Benergy80/PartitionSystem/ELEVATOR ENTRY SHOP AND STP FILES/Elevator Entry Inventory.jpg

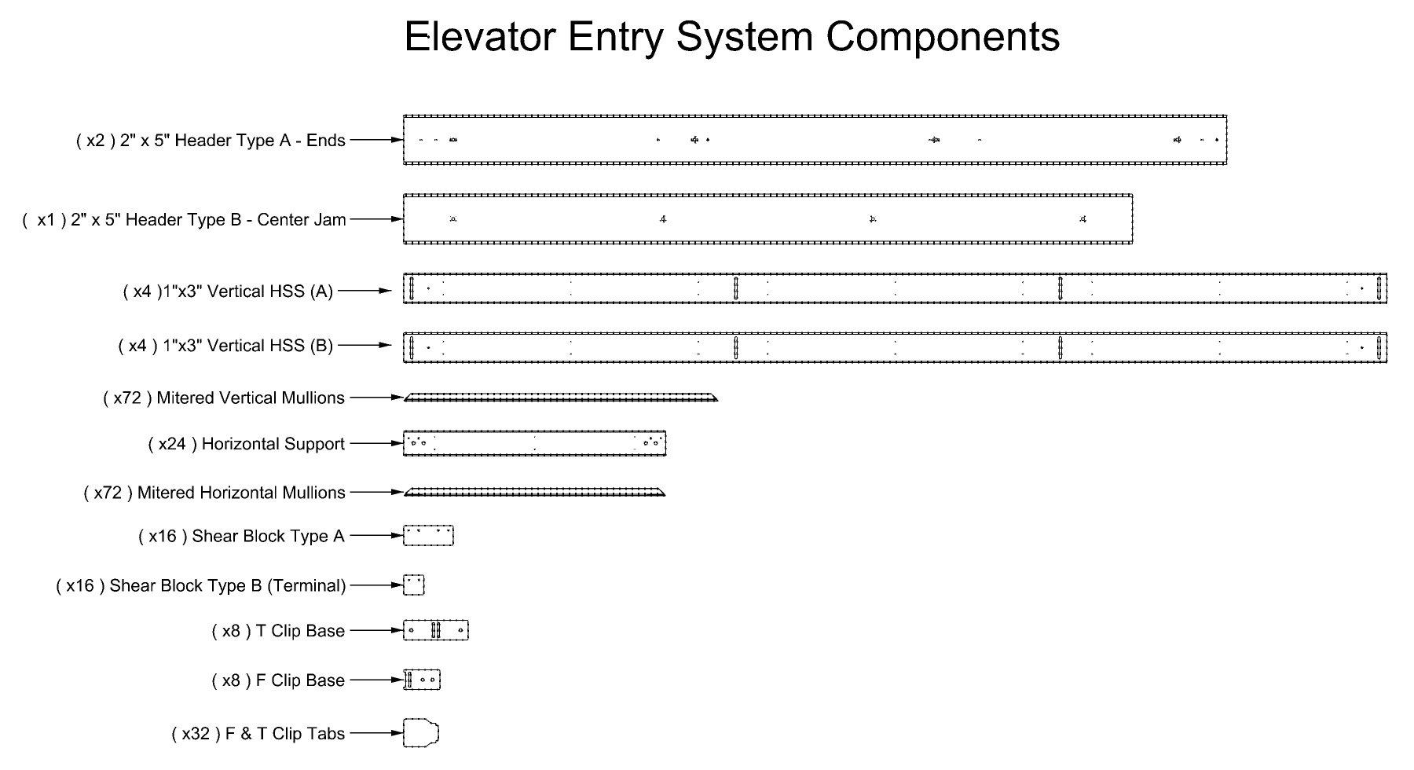
ELEVATOR ENTRY SHOP AND STP FILES/Elevator Entry Inventory.jpg
