Benergy80/PartitionSystem/ELEVATOR ENTRY SHOP AND STP FILES/EL Horizontal Support x24.stp

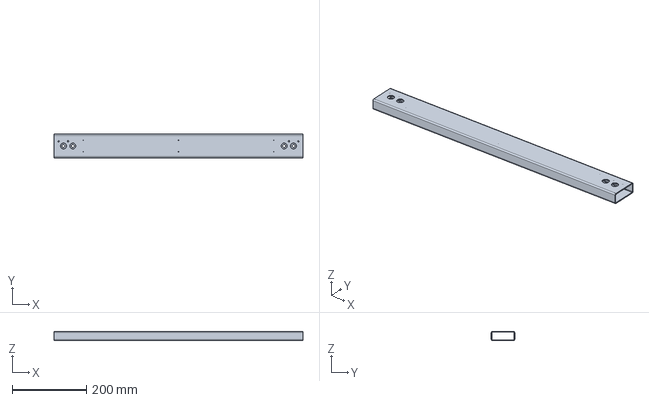
[picture p2: CAD file, 2026-07-02]
ELEVATOR ENTRY SHOP AND STP FILES/EL Horizontal Support x24.stp
671.8 x 63.5 x 25.4 mm
