Benergy80/PartitionSystem/ELEVATOR ENTRY SHOP AND STP FILES/Shear Block Type A x16.stp

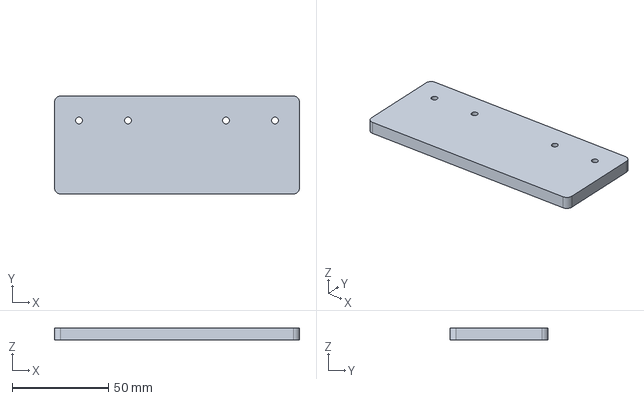
[picture p3: CAD file, 2026-07-02]
ELEVATOR ENTRY SHOP AND STP FILES/Shear Block Type A x16.stp
127.0 x 50.8 x 6.35 mm
