Benergy80/PartitionSystem/ELEVATOR ENTRY SHOP AND STP FILES/EL Vertical Support Type A x4.stp

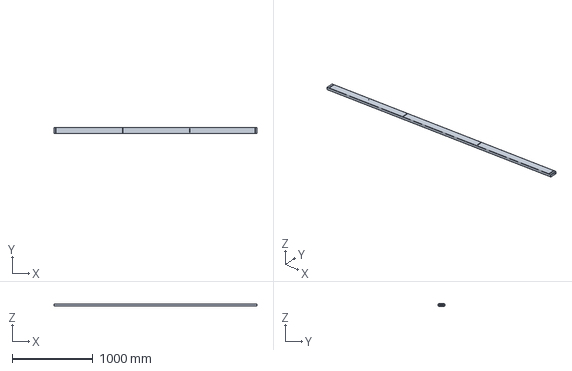
[picture p4: CAD file, 2026-07-02]
ELEVATOR ENTRY SHOP AND STP FILES/EL Vertical Support Type A x4.stp
2520.9 x 76.2 x 25.4 mm
