Benergy80/PartitionSystem/ELEVATOR ENTRY SHOP AND STP FILES/F & T Clip Tabs x32.stp

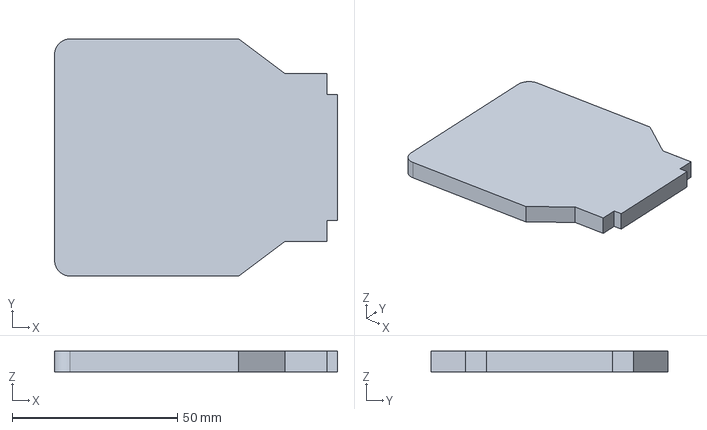
[picture p5: CAD file, 2026-07-02]
ELEVATOR ENTRY SHOP AND STP FILES/F & T Clip Tabs x32.stp
85.7 x 71.9 x 6.35 mm
