Benergy80/PartitionSystem/ELEVATOR ENTRY SHOP AND STP FILES/EL Mitered Vertical Mullions x72.stp

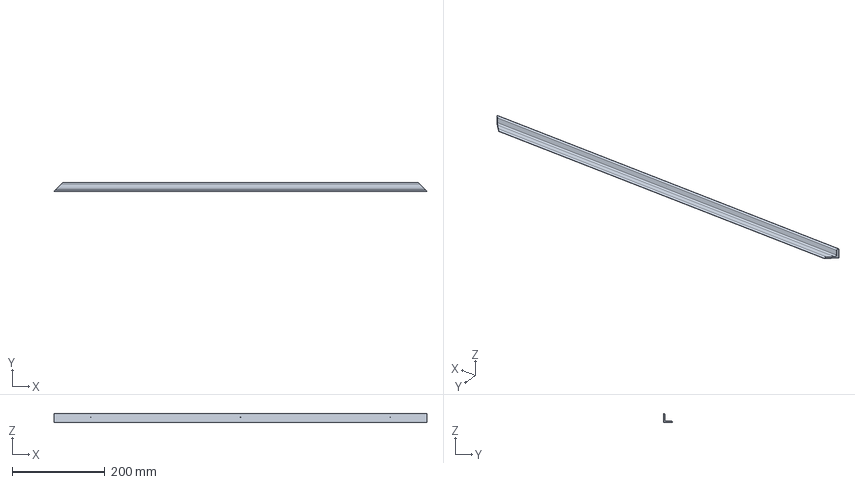
[picture p6: CAD file, 2026-07-02]
ELEVATOR ENTRY SHOP AND STP FILES/EL Mitered Vertical Mullions x72.stp
806.4 x 19.1 x 19.1 mm
