Benergy80/PartitionSystem/ELEVATOR ENTRY SHOP AND STP FILES/EL Header Type B x1.stp

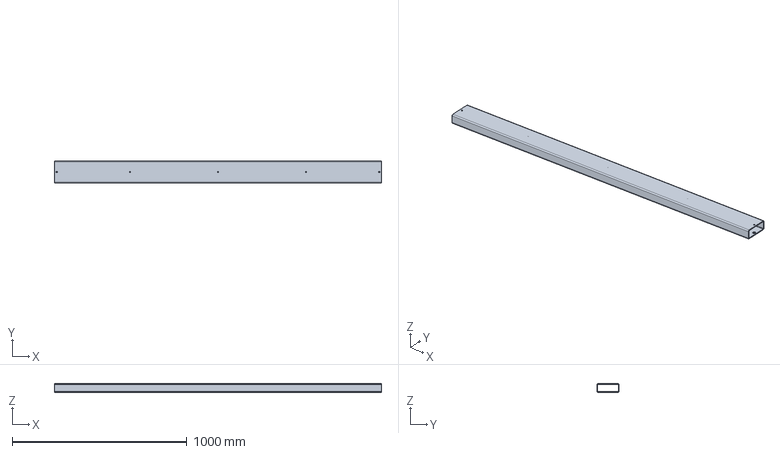
[picture p7: CAD file, 2026-07-02]
ELEVATOR ENTRY SHOP AND STP FILES/EL Header Type B x1.stp
1868.6 x 127.0 x 50.8 mm
