Benergy80/PartitionSystem/ELEVATOR ENTRY SHOP AND STP FILES/Shear Block Type B x16.stp

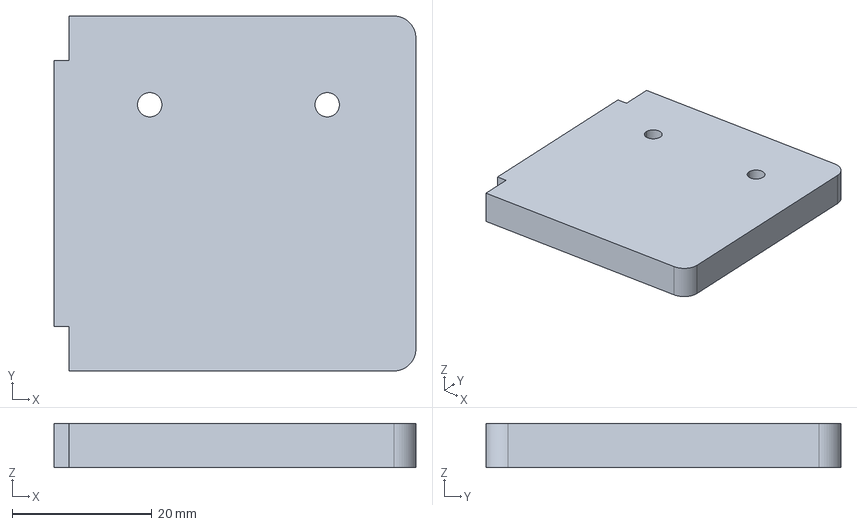
[picture p9: CAD file, 2026-07-02]
ELEVATOR ENTRY SHOP AND STP FILES/Shear Block Type B x16.stp
51.8 x 50.8 x 6.35 mm
