Benergy80/PartitionSystem/ELEVATOR ENTRY SHOP AND STP FILES/EL Header Type A x2.stp

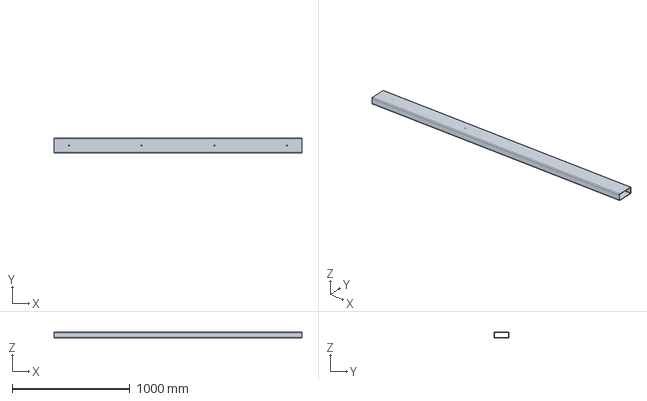
[picture p10: CAD file, 2026-07-02]
ELEVATOR ENTRY SHOP AND STP FILES/EL Header Type A x2.stp
2110.5 x 127.0 x 50.8 mm
