Benergy80/PartitionSystem/ELEVATOR ENTRY SHOP AND STP FILES/F Clip Base x8.stp

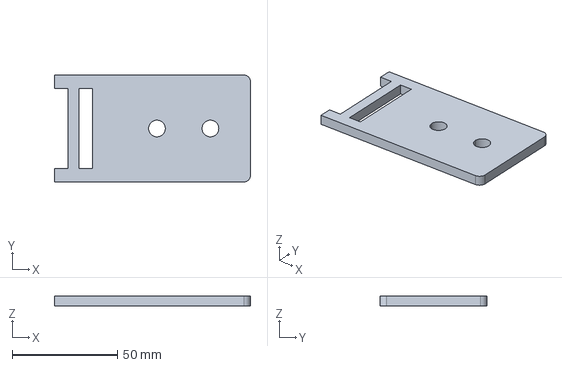
[picture p11: CAD file, 2026-07-02]
ELEVATOR ENTRY SHOP AND STP FILES/F Clip Base x8.stp
93.1 x 50.8 x 4.76 mm
