Benergy80/PartitionSystem/ELEVATOR ENTRY SHOP AND STP FILES/EL Mitered Horizontal Mullions x72.stp

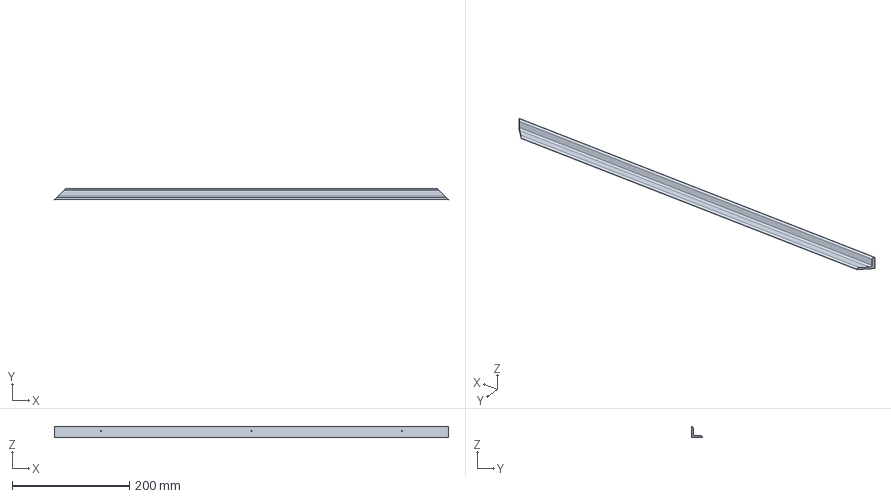
[picture p12: CAD file, 2026-07-02]
ELEVATOR ENTRY SHOP AND STP FILES/EL Mitered Horizontal Mullions x72.stp
671.8 x 19.1 x 19.1 mm
