Benergy80/PartitionSystem/(list of files, cad)

Other CAD files:
ELEVATOR ENTRY SHOP AND STP FILES/EL Vertical Support Type B x4.stp
