Benergy80/PartitionSystem/102219.004.01 - ChiLabs 6th Floor Elevator Entrance and Board 020524 (1).pdf

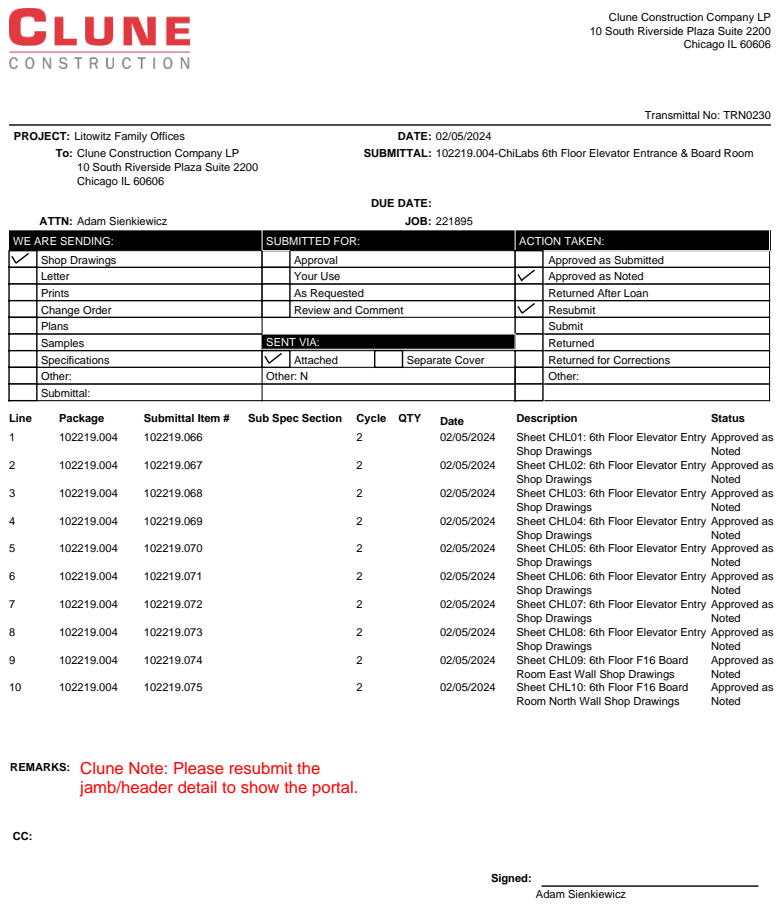
[picture p13: page 1]
Transmittal No: TRN0230; Chicago IL 60606; PROJECT: Litowitz Family Offices; DATE: 02/05/2024; DUE DATE:; ATTN: Adam Sienkiewicz; JOB: 221895; WE ARE SENDING: Shop Drawings; Change Order; SENT VIA:; Other: N; Attached; Separate Cover; Line; Package; Submittal Item #; Sub Spec Section Cycle QTY; Date; Description; Status; Sheet CHL01: 6th Floor Elevator Entry; Shop Drawings; Approved as; Sheet CHL02: 6th Floor Elevator Entry; Sheet CHL03: 6th Floor Elevator Entry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

Clune Construction Company LP
10 South Riverside Plaza Suite 2200

Chicago IL 60606

SUBMITTAL: 102219.004-ChiLabs 6th Floor Elevator Entrance & Board Room

SUBMITTED FOR:
Approval
Your Use
As Requested
Review and Comment

ACTION TAKEN:
Approved as Submitted
Approved as Noted
Returned After Loan
Resubmit
Submit
Returned
Returned for Corrections
Other:

Room East Wall Shop Drawings

Room North Wall Shop Drawings

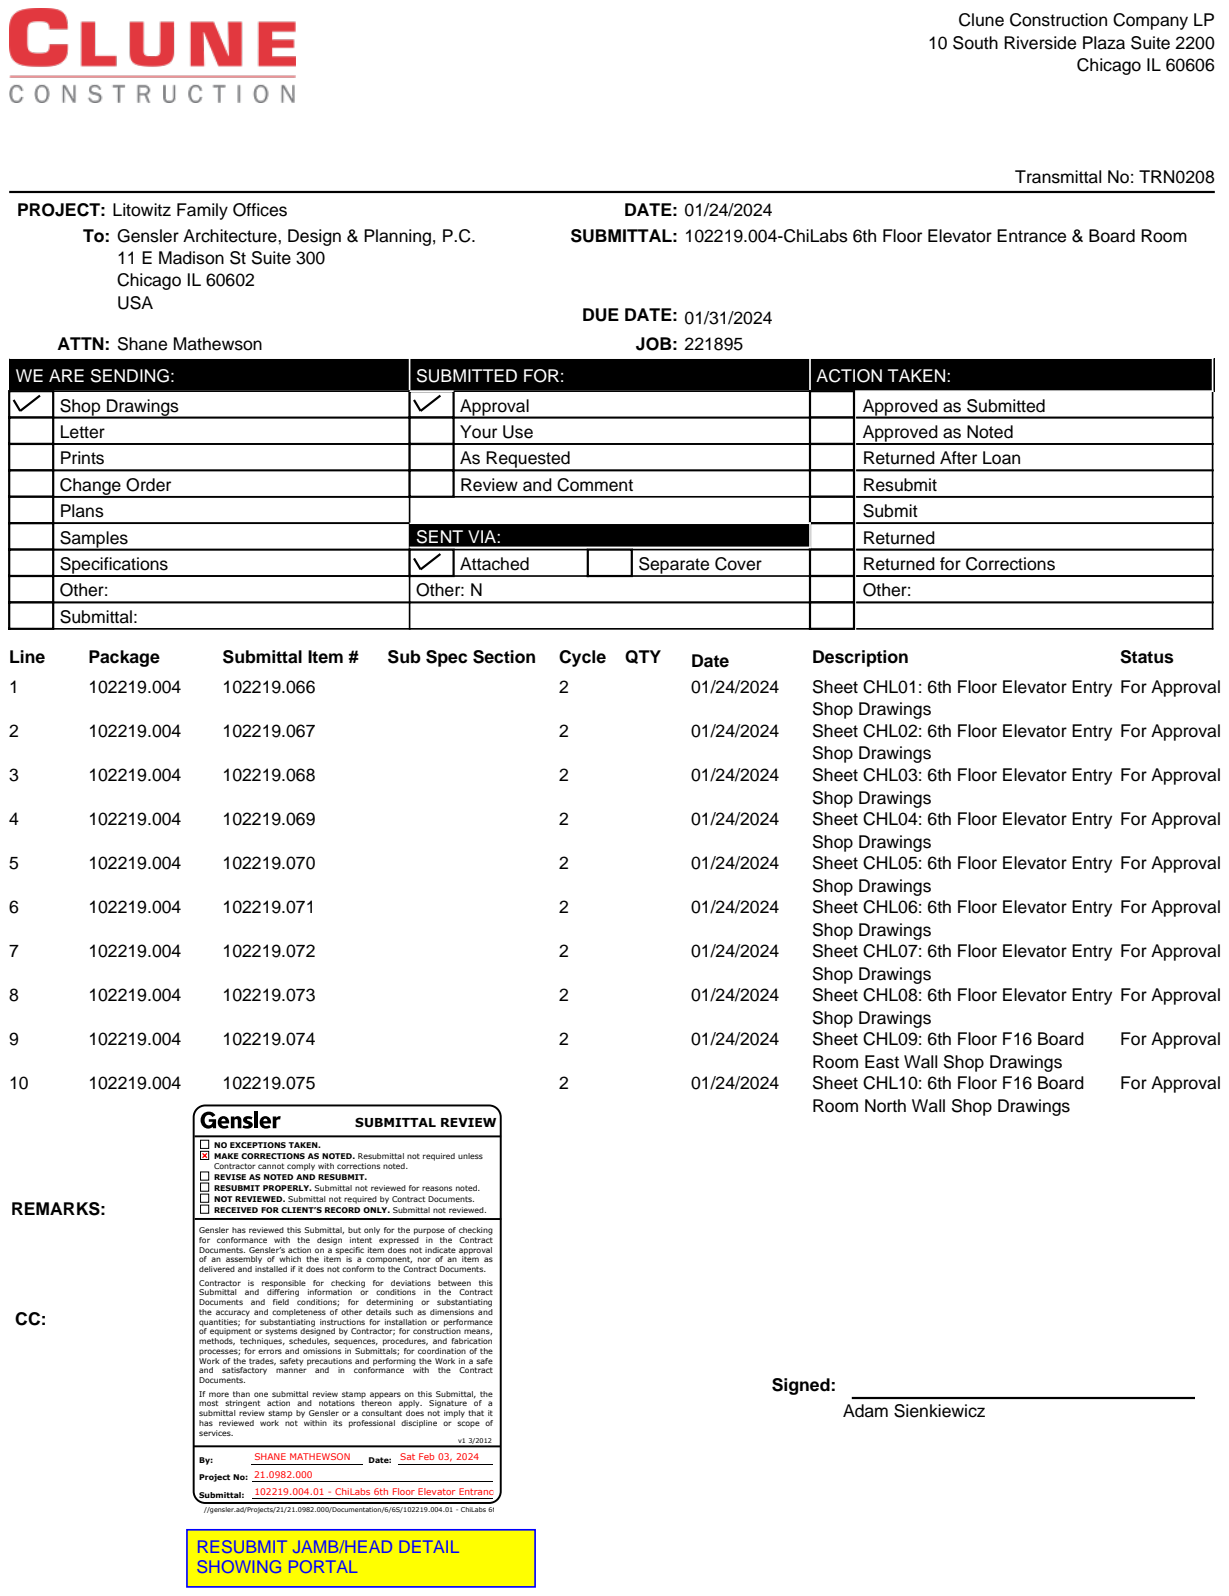
[picture p14: page 2]
Transmittal No: TRN0208; Chicago IL 60606; PROJECT: Litowitz Family Offices; DATE: 01/24/2024; DUE DATE:; ATTN: Shane Mathewson; JOB: 221895; WE ARE SENDING: Shop Drawings; Change Order; SENT VIA:; Other: N; Attached; Separate Cover; Line; Package; Submittal Item #; Sub Spec Section Cycle QTY; Date; Description; Status; Sheet CHL01: 6th Floor Elevator Entry; Shop Drawings; For Approval; Sheet CHL02: 6th Floor Elevator Entry; Sheet CHL03: 6th Floor Elevator Entry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

Clune Construction Company LP
10 South Riverside Plaza Suite 2200

Gensler Architecture, Design & Planning, P.C.
11 E Madison St Suite 300
Chicago IL 60602
USA

102219.004-ChiLabs 6th Floor Elevator Entrance & Board Room

SUBMITTED FOR:
Approval
Your Use
As Requested
Review and Comment

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

Room East Wall Shop Drawings

Room North Wall Shop Drawings

NO EXCEPTIONS TAKEN.
MAKE CORRECTIONS AS NOTED. Resubmittal not required unless
Contractor cannot comply with corrections noted.
REVISE AS NOTED AND RESUBMIT.
RESUBMIT PROPERLY. Submittal not reviewed for reasons noted.
NOT REVIEWED. Submittal not required by Contract Documents.
RECEIVED FOR CLIENT’S RECORD ONLY. Submittal not reviewed.
Gensler has reviewed this Submittal, but only for the purpose of checking
for conformance with the design intent expressed in the Contract
Documents. Gensler’s action on a specific item does not indicate approval
of an assembly of which the item is a component, nor of an item as
delivered and installed if it does not conform to the Contract Documents.
Contractor is responsible for checking for deviations between this
Submittal and differing information or conditions in the Contract
Documents and field conditions; for determining or substantiating
the accuracy and completeness of other details such as dimensions and
quantities; for substantiating instructions for installation or performance
of equipment or systems designed by Contractor; for construction means,
methods, techniques, schedules, sequences, procedures, and fabrication
processes; for errors and omissions in Submittals; for coordination of the
Work of the trades, safety precautions and performing the Work in a safe
and satisfactory manner and in conformance with the Contract
Documents.
If more than one submittal review stamp appears on this Submittal, the
most stringent action and notations thereon apply. Signature of a
submittal review stamp by Gensler or a consultant does not imply that it
has reviewed work not within its professional discipline or scope of

RESUBMIT JAMB/HEAD DETAIL
SHOWING PORTAL

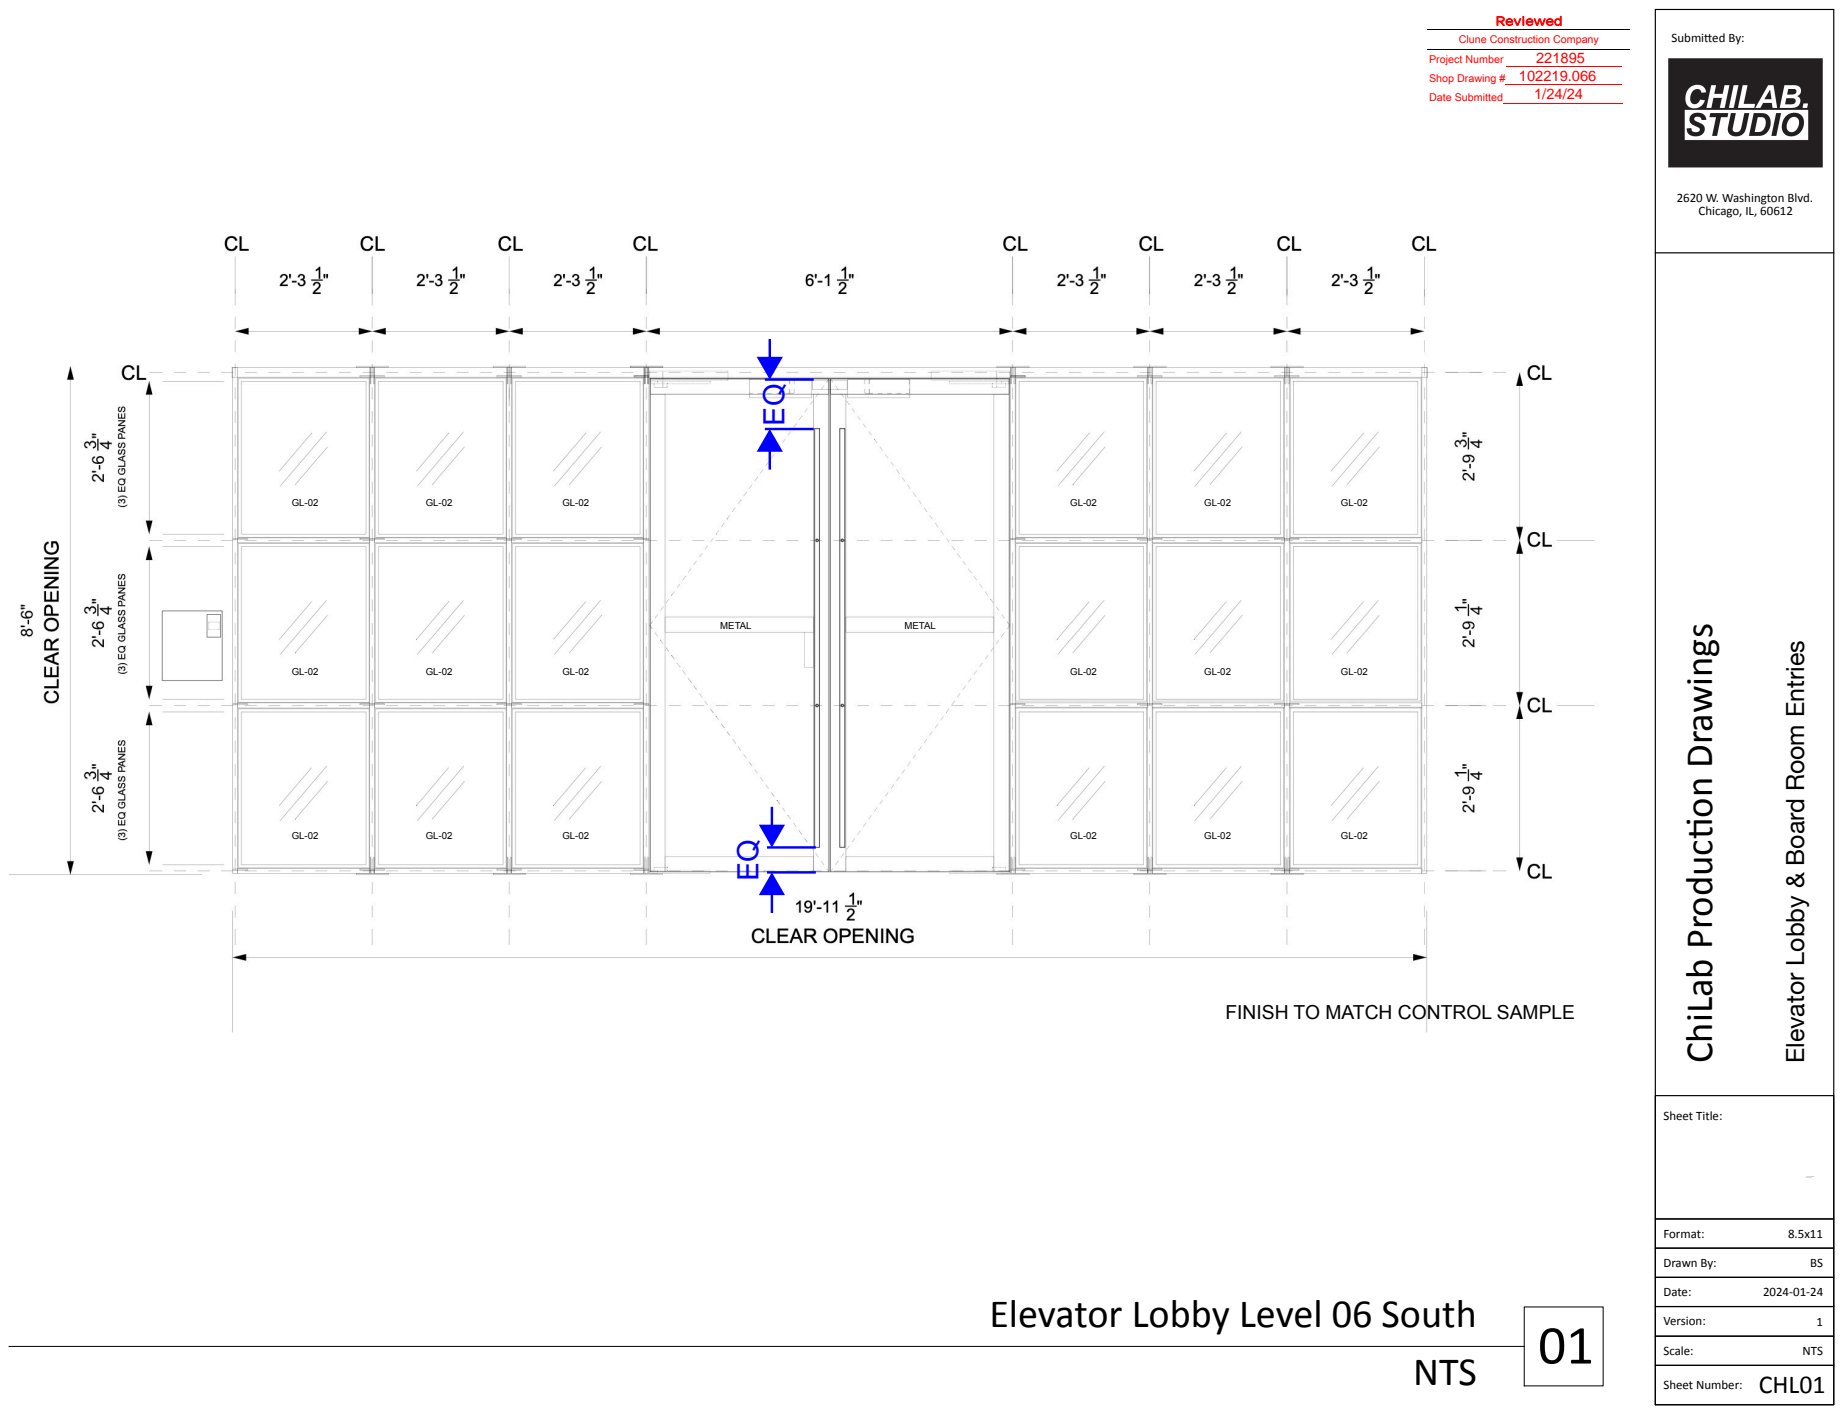
[picture p15: page 3]
Elevator Lobby Level 06 South; Sheet Number:; Drawn By:; Sheet Title:; 2620 W. Washington Blvd. Chicago, IL, 60612; Project Number Shop Drawing #; Date Submitted

Reviewed
Clune Construction Company
SubmiFed By: ChiLab Produc5on Drawings

Elevator Lobby & Board Room Entries

FINISH TO MATCH CONTROL SAMPLE

Elevator Lobby Eleva5on
Sheet Title Line 2

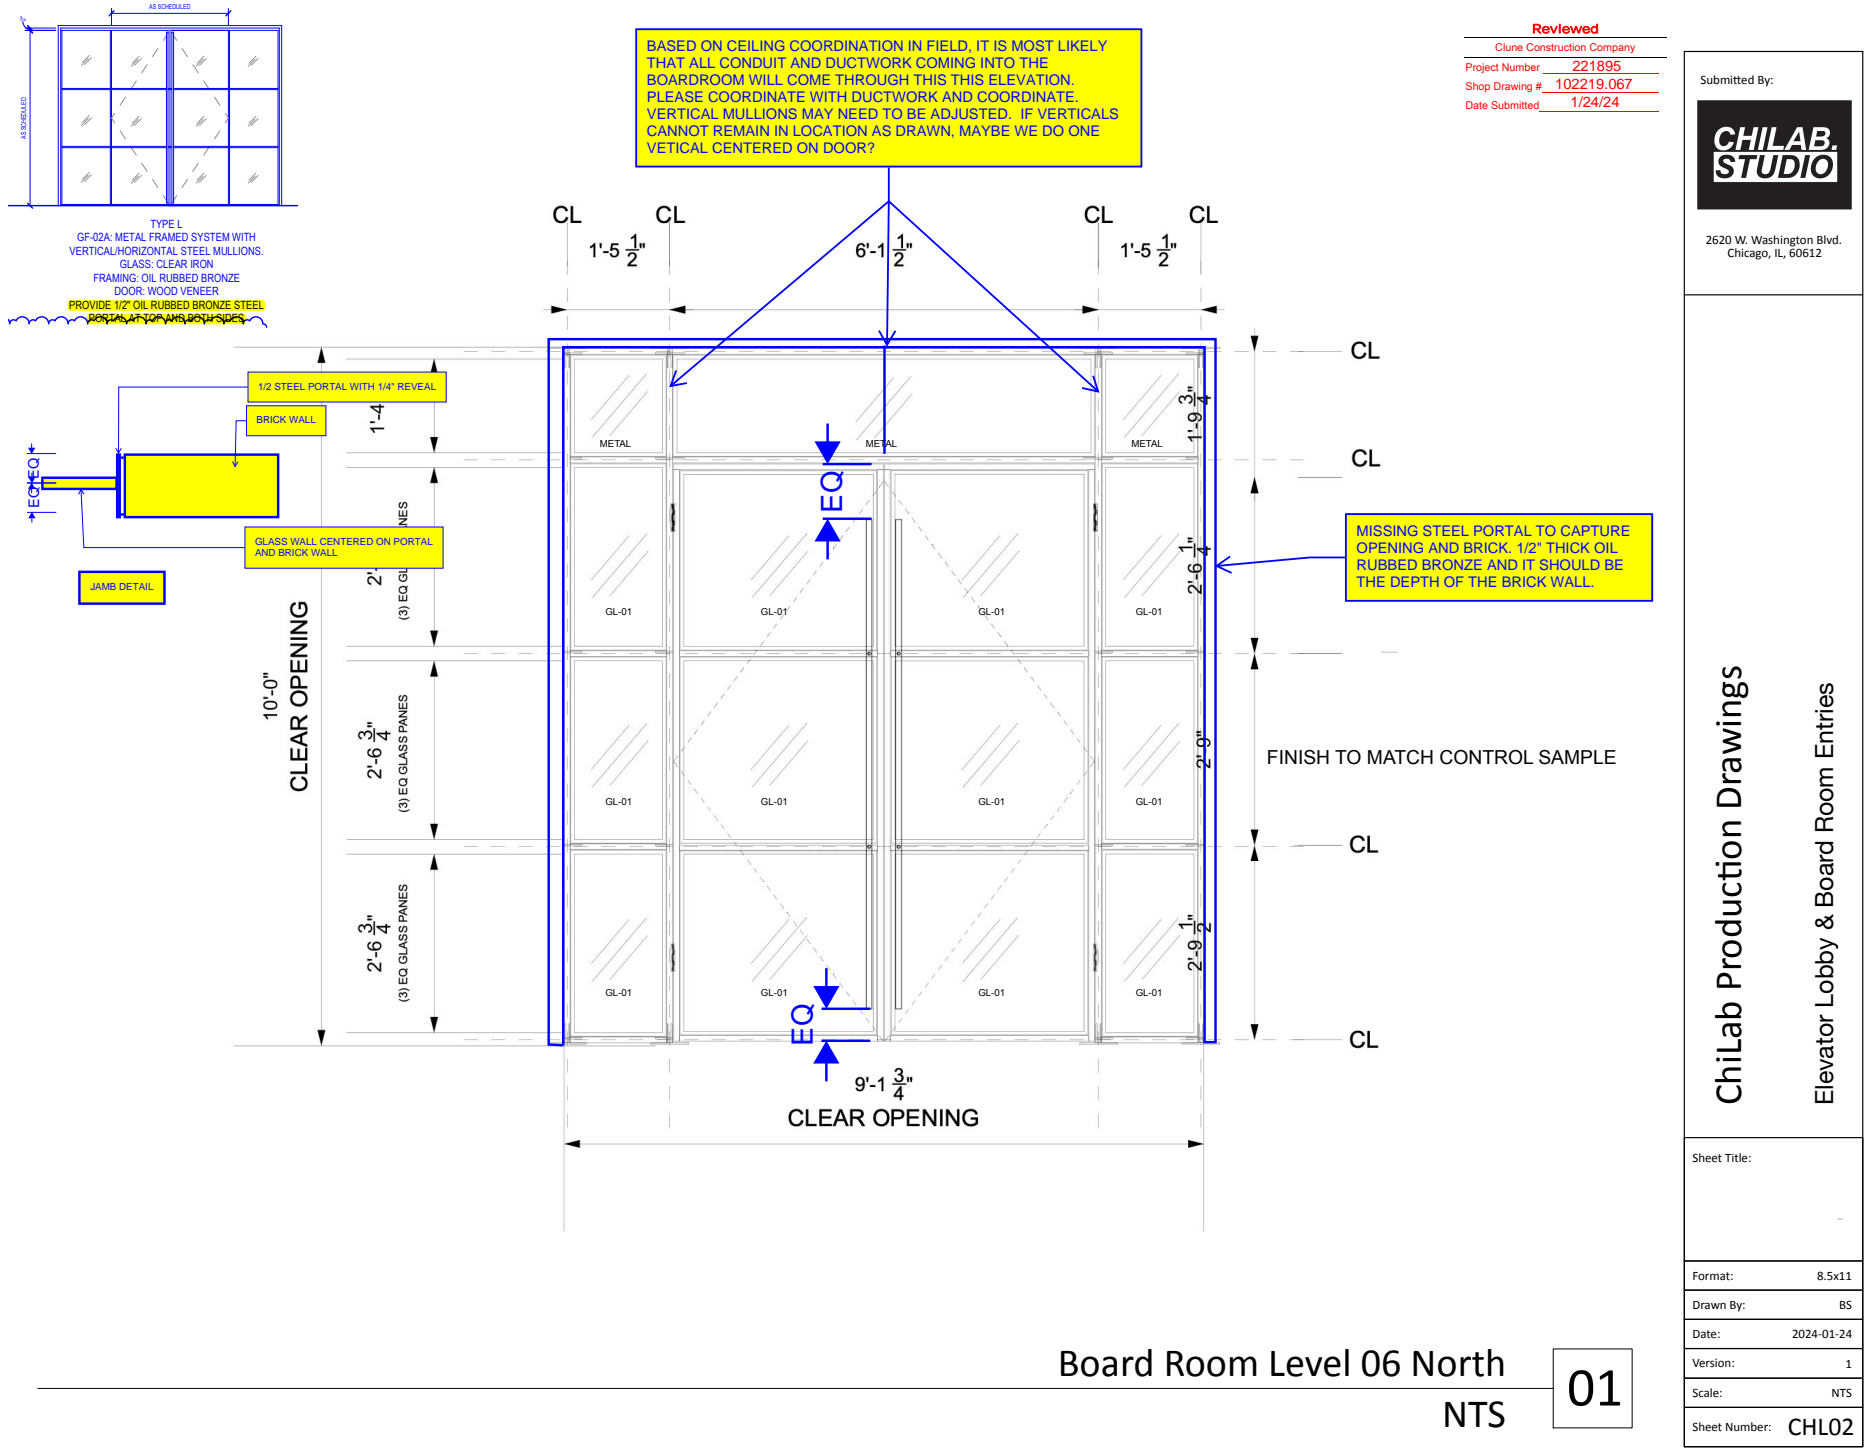
[picture p16: page 4]
Board Room Level 06 North; Drawn By:; Sheet Title:; 2620 W. Washington Blvd. Chicago, IL, 60612; Date Submitted; TYPE L; AS SCHEDULED; AS SCHEDULED 2"; BRICK WALL; JAMB DETAIL

BASED ON CEILING COORDINATION IN FIELD, IT IS MOST LIKELY
THAT ALL CONDUIT AND DUCTWORK COMING INTO THE
BOARDROOM WILL COME THROUGH THIS THIS ELEVATION.
PLEASE COORDINATE WITH DUCTWORK AND COORDINATE.
VERTICAL MULLIONS MAY NEED TO BE ADJUSTED. IF VERTICALS
CANNOT REMAIN IN LOCATION AS DRAWN, MAYBE WE DO ONE
VETICAL CENTERED ON DOOR?

SubmiFed By: ChiLab Produc5on Drawings

GF-02A: METAL FRAMED SYSTEM WITH
VERTICAL/HORIZONTAL STEEL MULLIONS.

GLASS: CLEAR IRON
FRAMING: OIL RUBBED BRONZE
DOOR: WOOD VENEER

PROVIDE 1/2" OIL RUBBED BRONZE STEEL
PORTAL AT TOP AND BOTH SIDES

1/2 STEEL PORTAL WITH 1/4" REVEAL

GLASS WALL CENTERED ON PORTAL
AND BRICK WALL

MISSING STEEL PORTAL TO CAPTURE
OPENING AND BRICK. 1/2" THICK OIL
RUBBED BRONZE AND IT SHOULD BE
THE DEPTH OF THE BRICK WALL.

Elevator Lobby & Board Room Entries

FINISH TO MATCH CONTROL SAMPLE

Sheet Title Line 1
Sheet Title Line 2

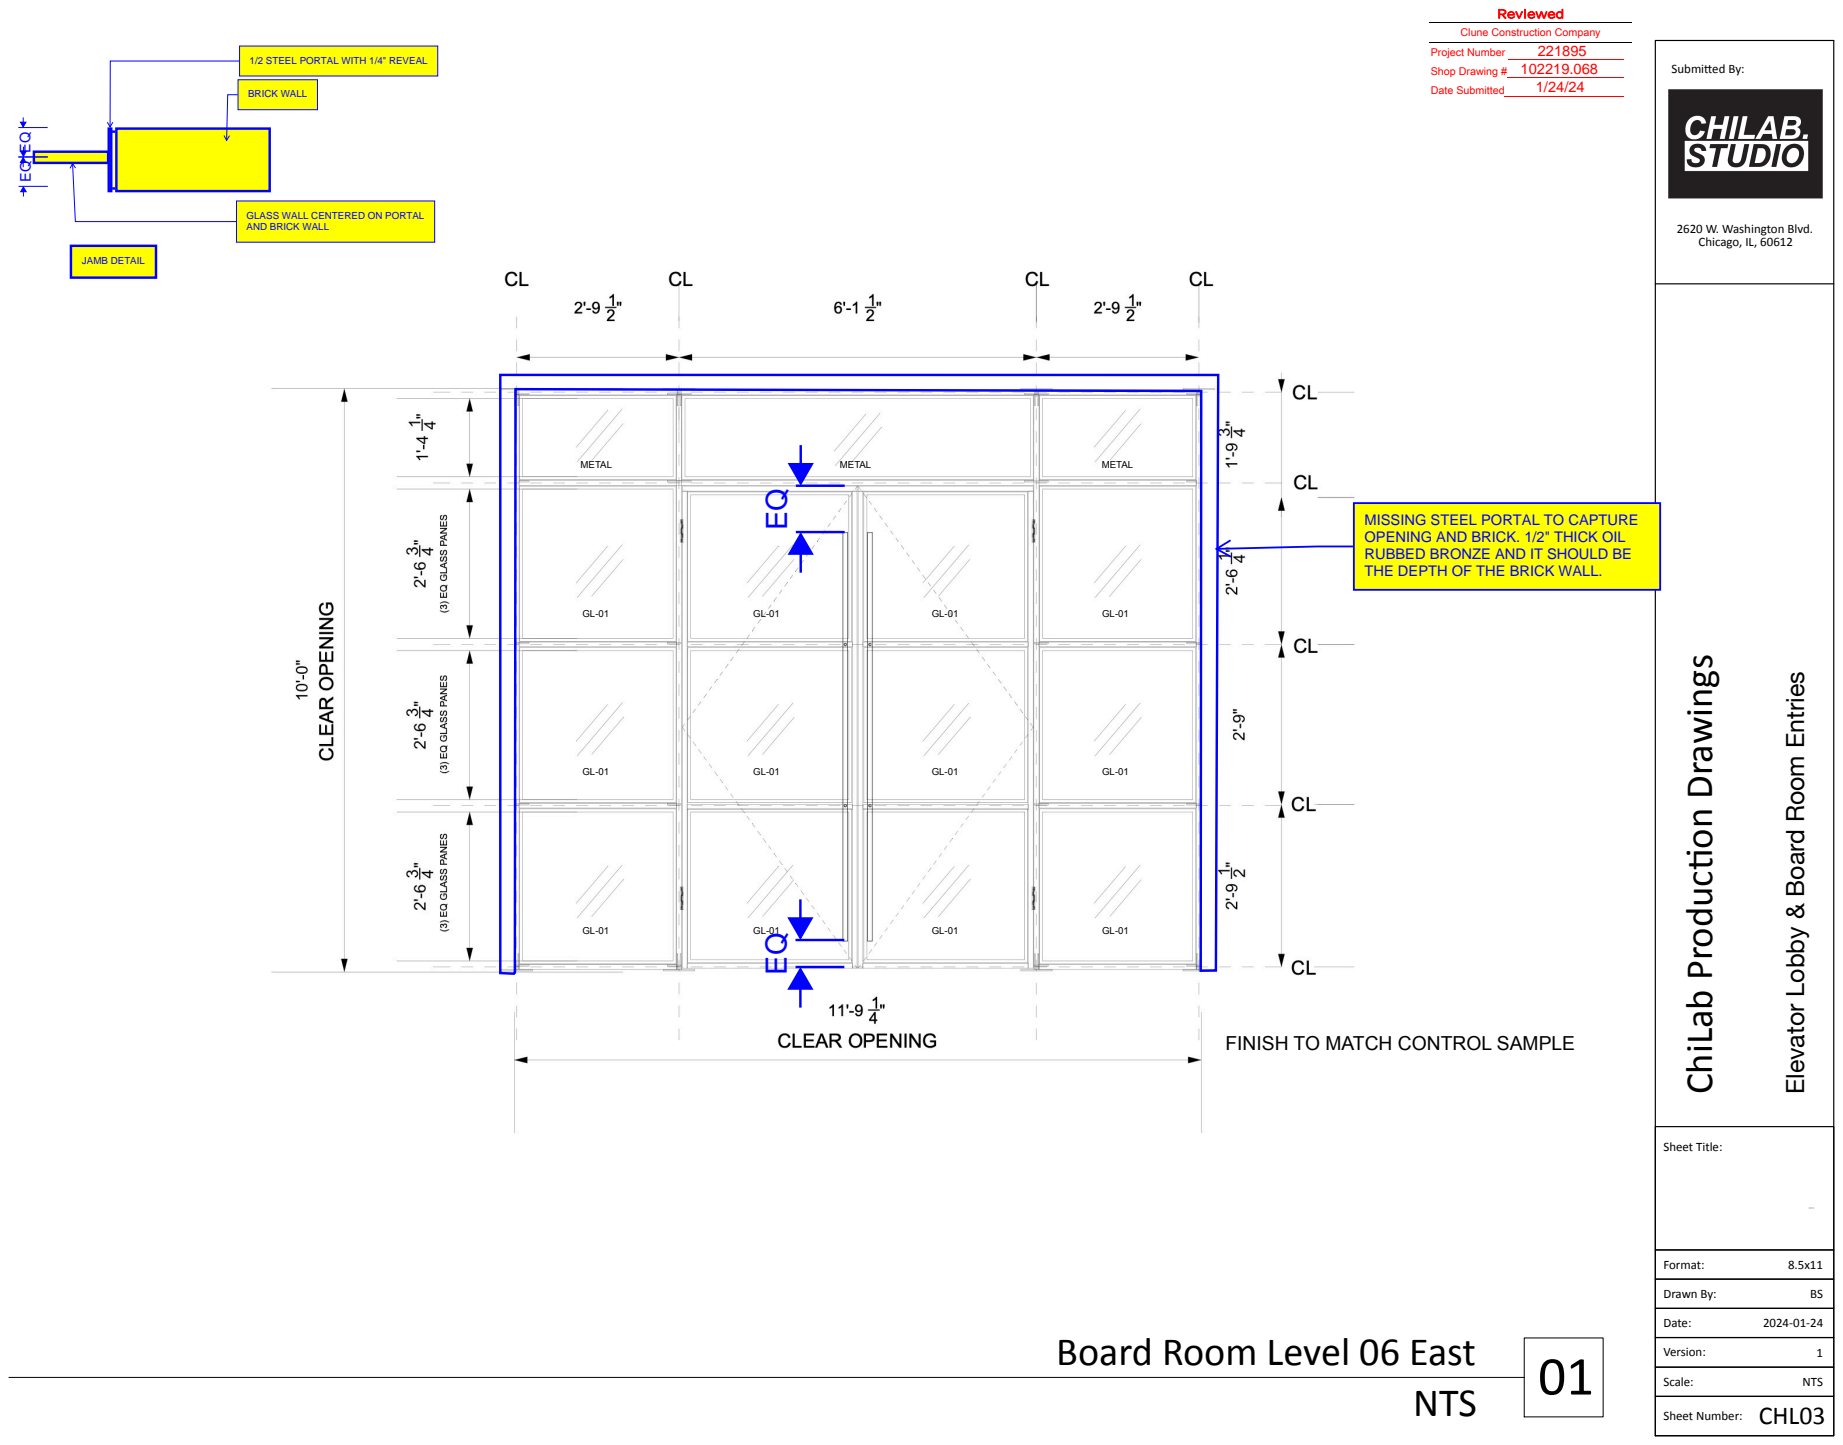
[picture p17: page 5]
Board Room Level 06 East; Drawn By:; Sheet Title:; 2620 W. Washington Blvd. Chicago, IL, 60612; Date Submitted; BRICK WALL; JAMB DETAIL

1/2 STEEL PORTAL WITH 1/4" REVEAL

SubmiFed By: ChiLab Produc5on Drawings

GLASS WALL CENTERED ON PORTAL
AND BRICK WALL

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

Elevator Lobby & Board Room Entries

FINISH TO MATCH CONTROL SAMPLE

Sheet Title Line 1
Sheet Title Line 2

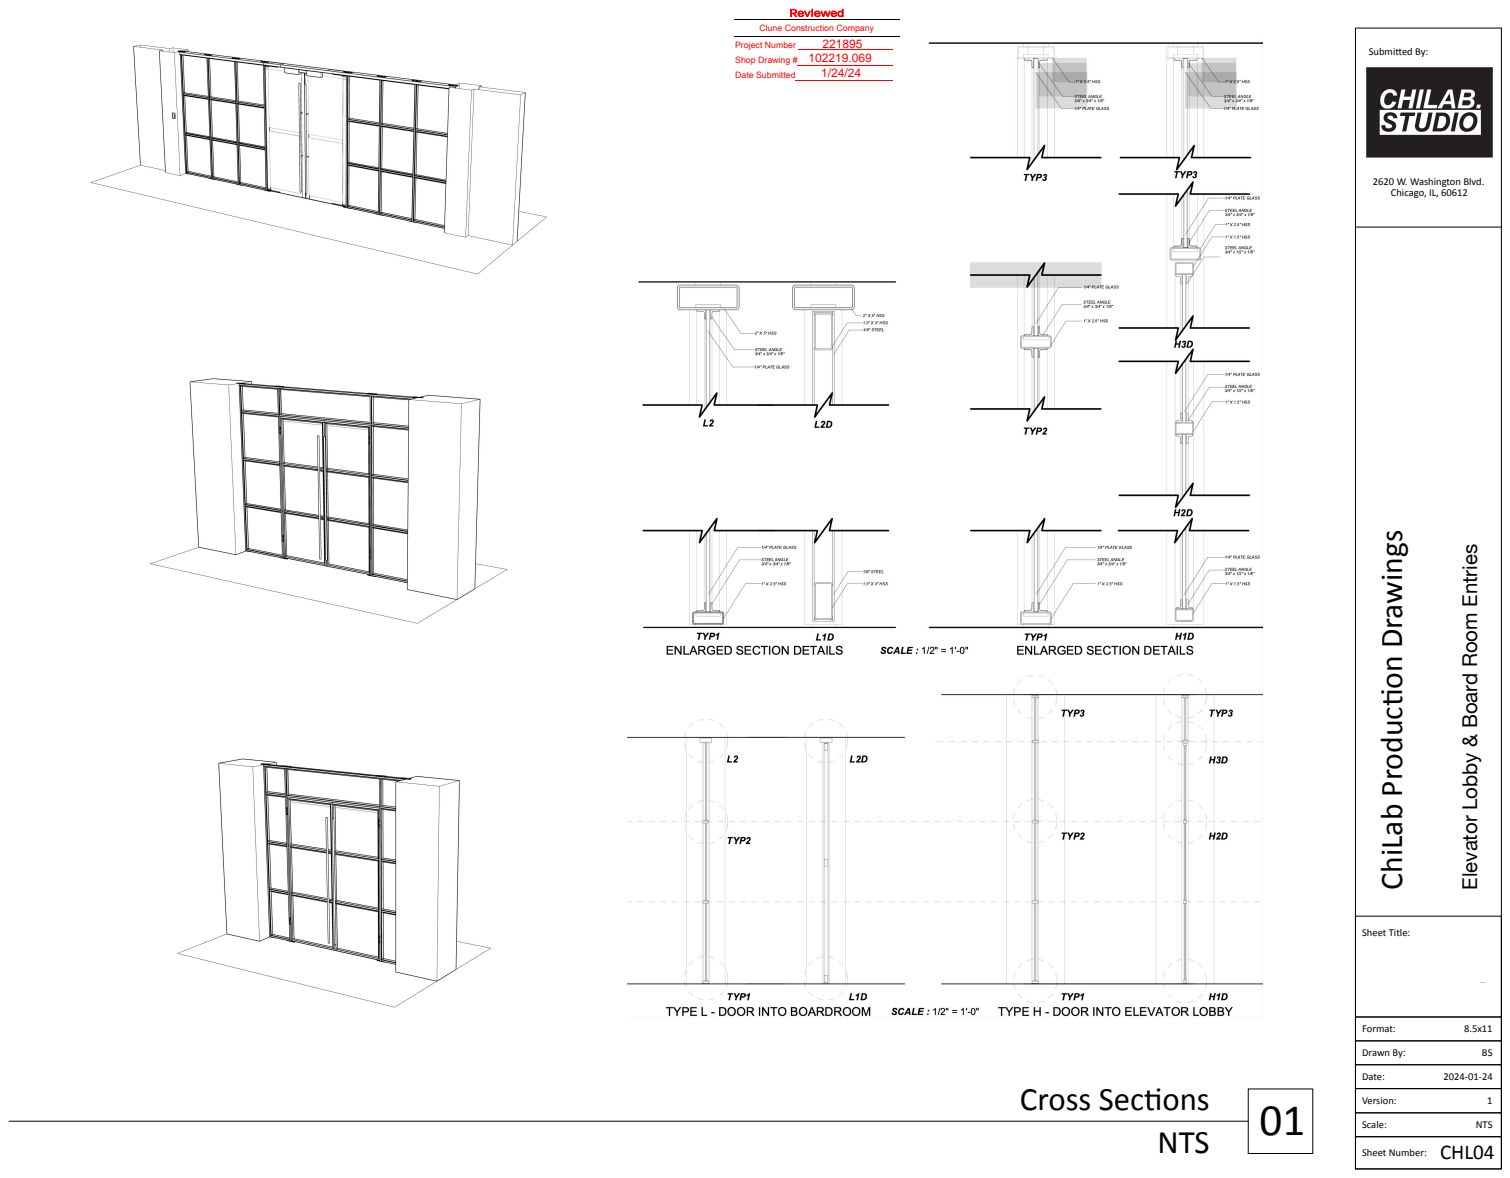
[picture p18: page 6]
Cross Sec+ons; Drawn By:; Sheet Title:; 2620 W. Washington Blvd. Chicago, IL, 60612; Date Submitted

SubmiCed By: ChiLab Produc+on Drawings

Elevator Lobby & Board Room Entries

Sheet Title Line 1
Sheet Title Line 2

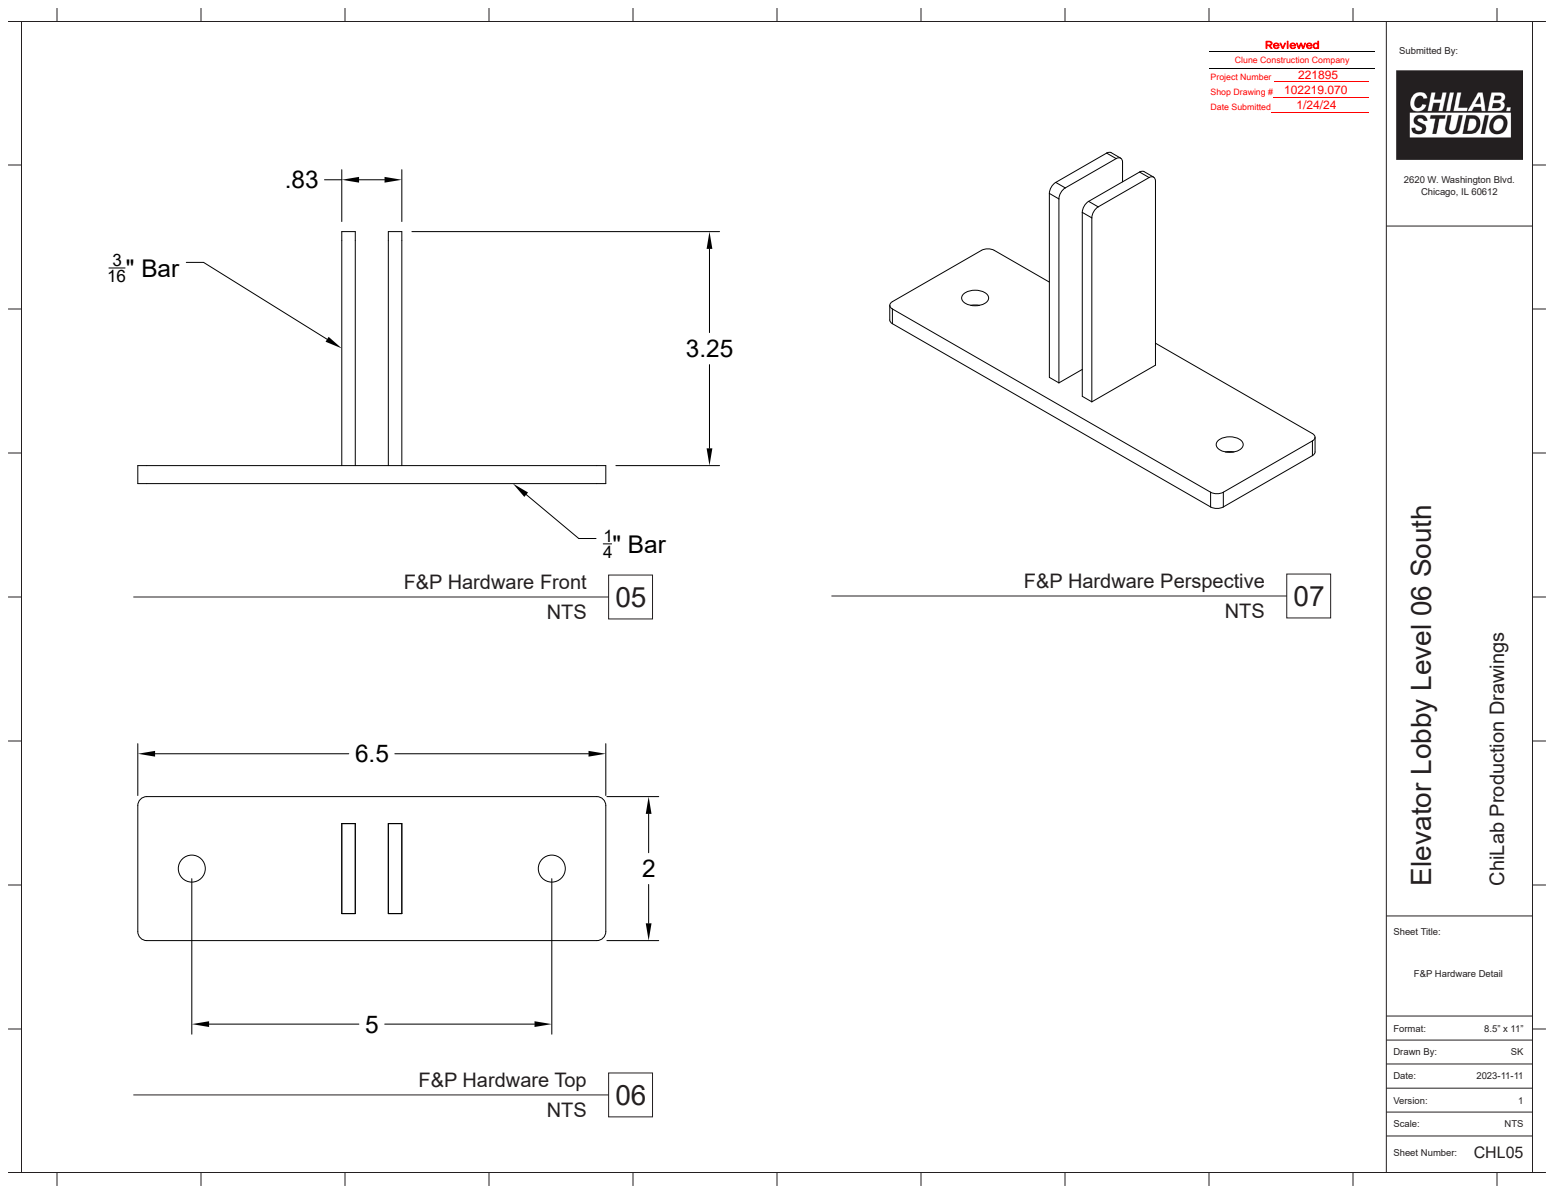
[picture p19: page 7]
16" Bar; 4" Bar; Submitted By:; 2620 W. Washington Blvd. Chicago, IL 60612; Sheet Title:; F&P Hardware Detail; Format:; Drawn By:; Sheet Number:; CHL05; F&P Hardware Top; F&P Hardware Front; NTS; F&P Hardware Perspective; Shop Drawing #; Date Submitted

Elevator Lobby Level 06 South

ChiLab Production Drawings

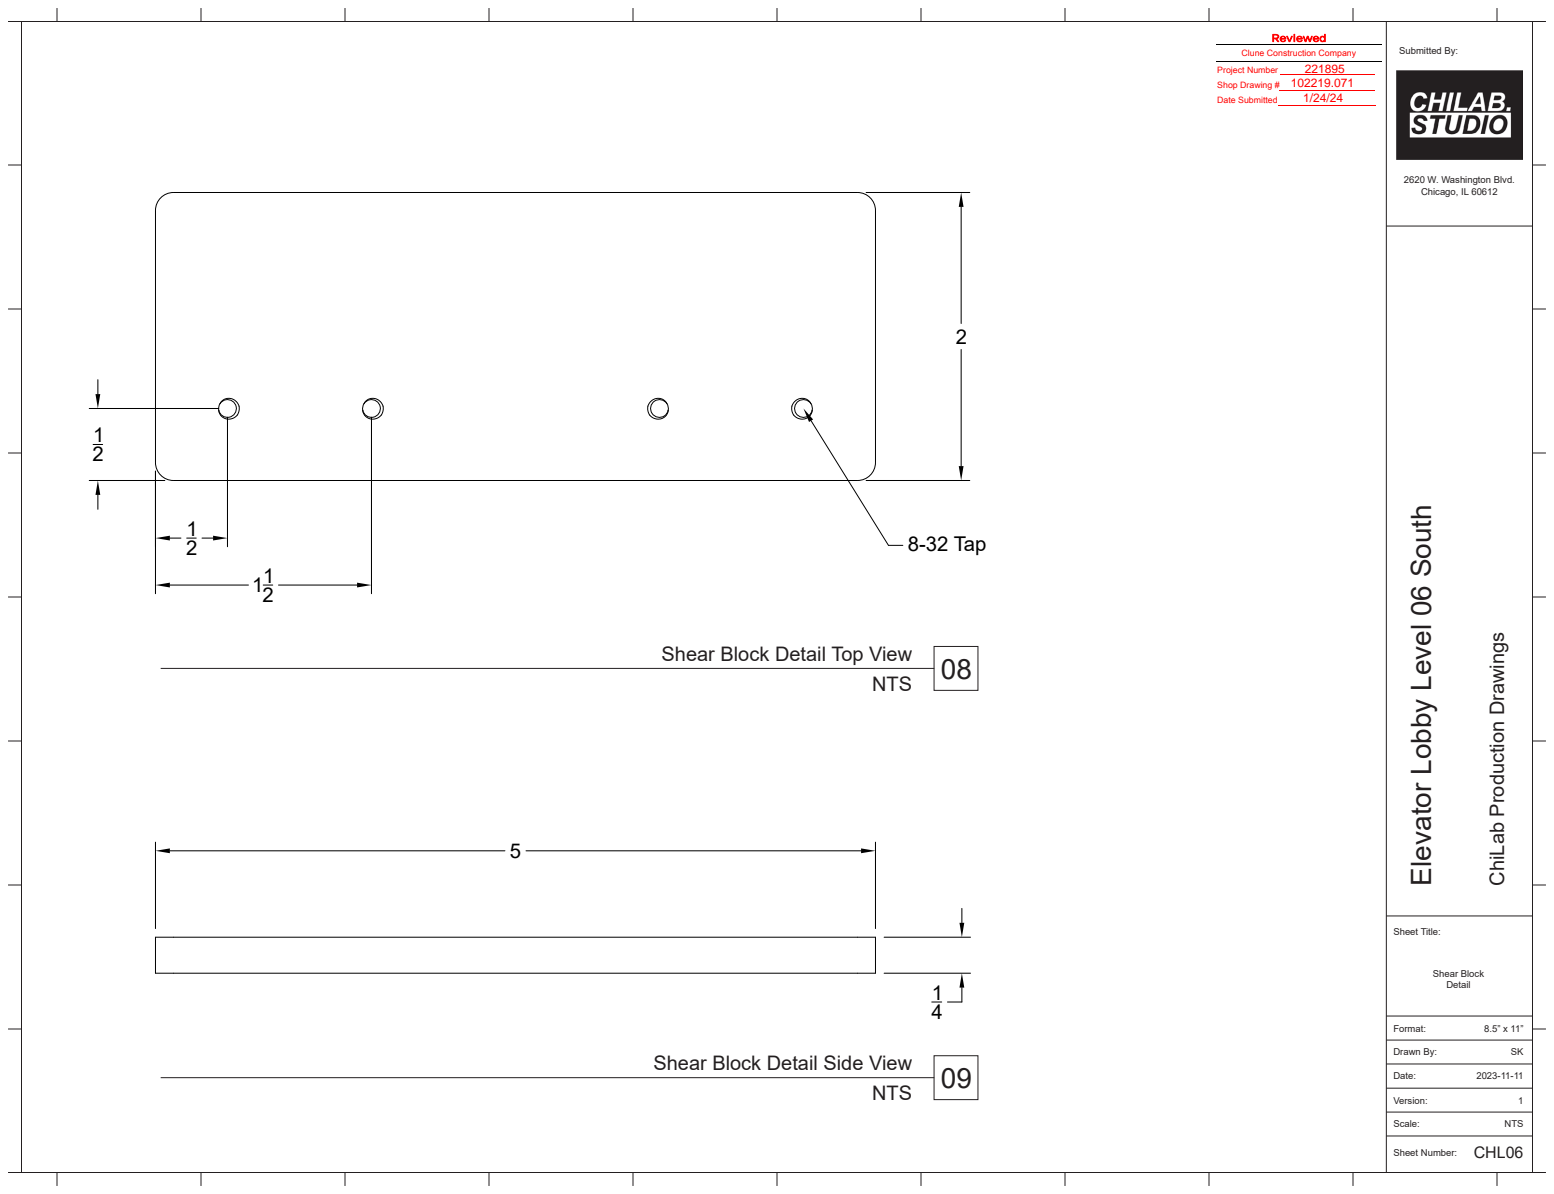
[picture p20: page 8]
8-32 Tap; Submitted By:; 2620 W. Washington Blvd. Chicago, IL 60612; Sheet Title:; Shear Block; Format:; Drawn By:; Sheet Number:; CHL06; Date Submitted

Elevator Lobby Level 06 South

ChiLab Production Drawings

Shear Block Detail Top View

Shear Block Detail Side View

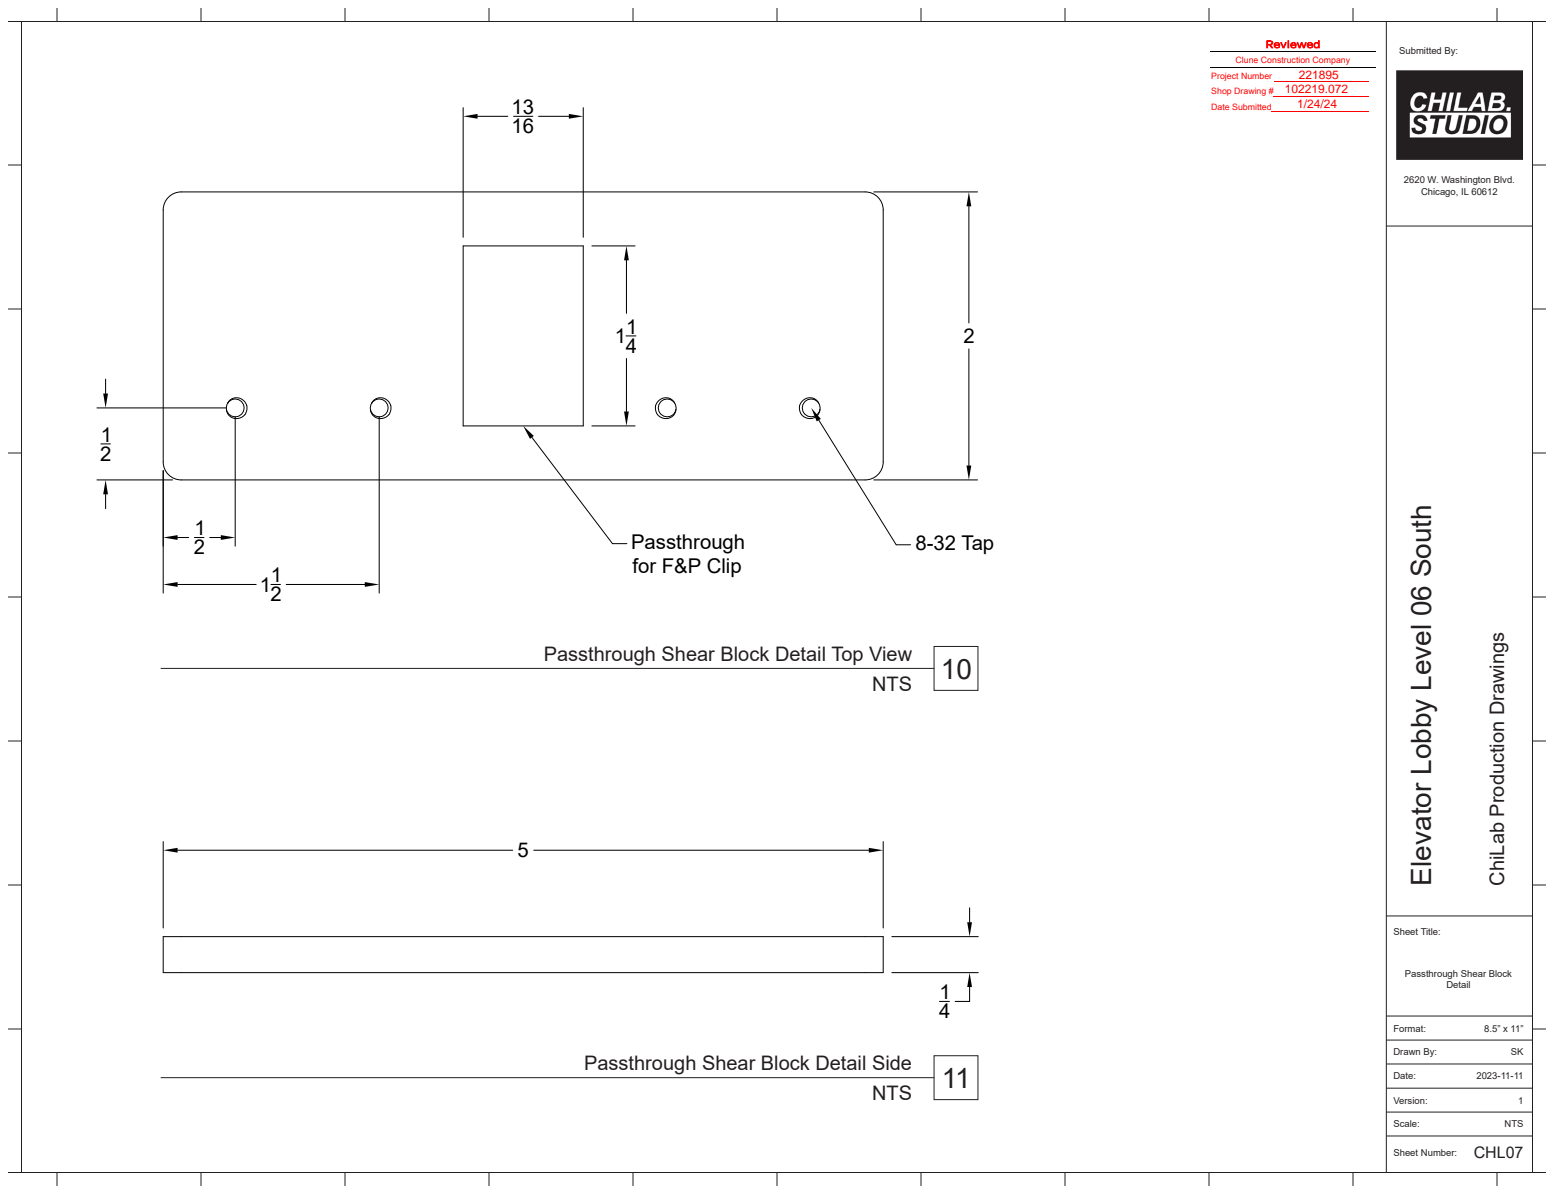
[picture p21: page 9]
Passthrough; 8-32 Tap; for F&P Clip; Submitted By:; 2620 W. Washington Blvd. Chicago, IL 60612; Sheet Title:; Format:; Drawn By:; Sheet Number:; CHL07; Shop Drawing #; Date Submitted

Elevator Lobby Level 06 South

ChiLab Production Drawings

Passthrough Shear Block Detail Top View

Passthrough Shear Block

Passthrough Shear Block Detail Side

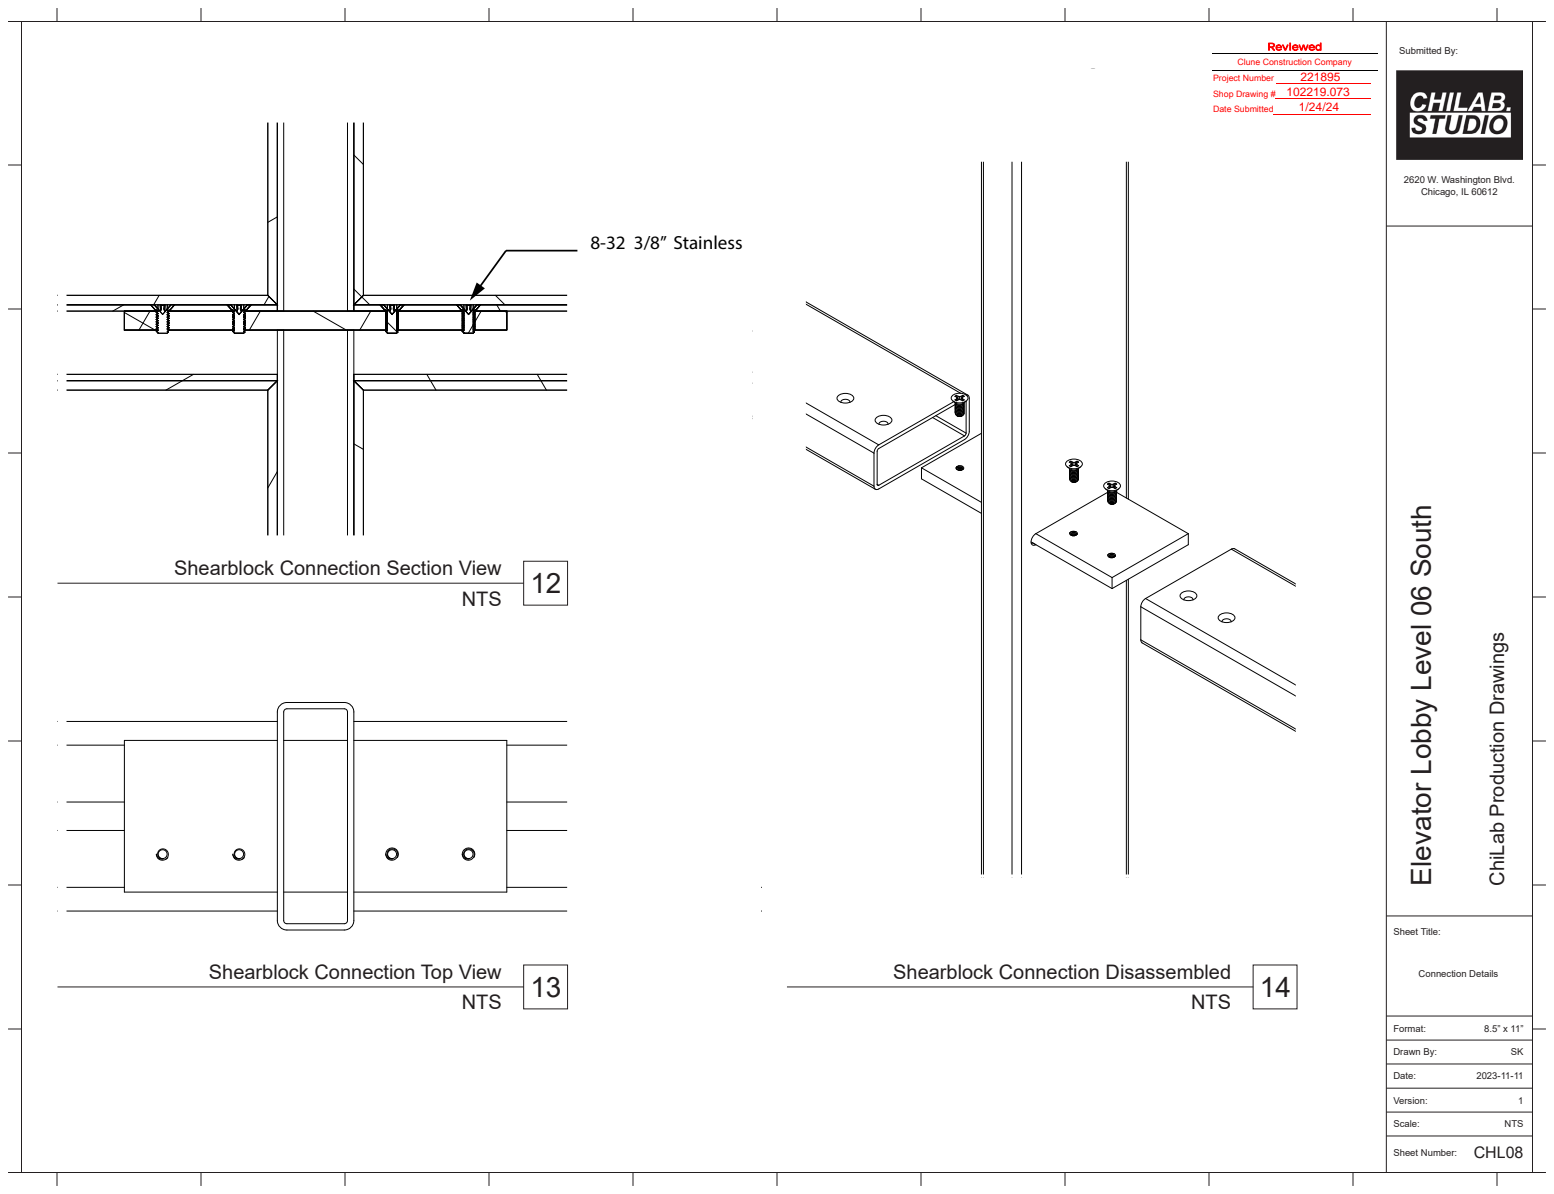
[picture p22: page 10]
8-32 3/8” Stainless; Submitted By:; 2620 W. Washington Blvd. Chicago, IL 60612; Sheet Title:; Connection Details; Format:; Drawn By:; Sheet Number:; CHL08; NTS; 14 Shearblock Connection Disassembled; Shop Drawing #; Date Submitted

Elevator Lobby Level 06 South

Shearblock Connection Section View

ChiLab Production Drawings

Shearblock Connection Top View

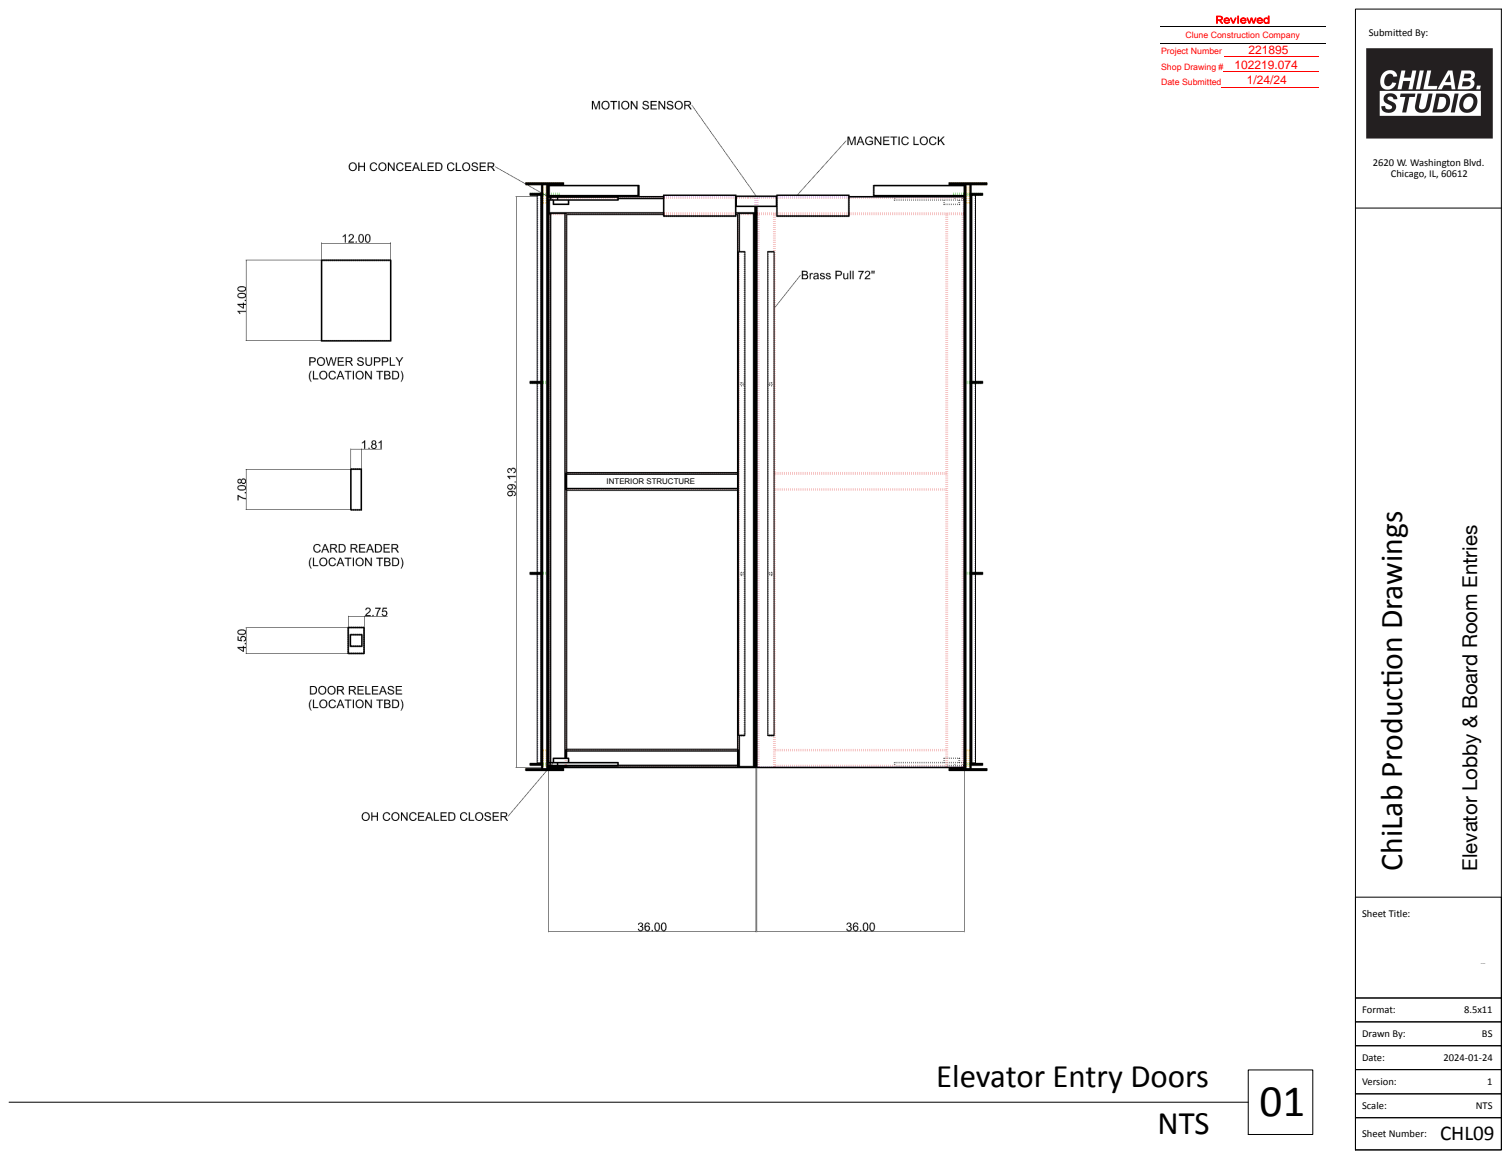
[picture p23: page 11]
Elevator Entry Doors; Drawn By:; Sheet Title:; 2620 W. Washington Blvd. Chicago, IL, 60612; INTERIOR STRUCTURE; Date Submitted

SubmiEed By: ChiLab ProducHon Drawings

Elevator Lobby & Board Room Entries

Sheet Title Line 1
Sheet Title Line 2

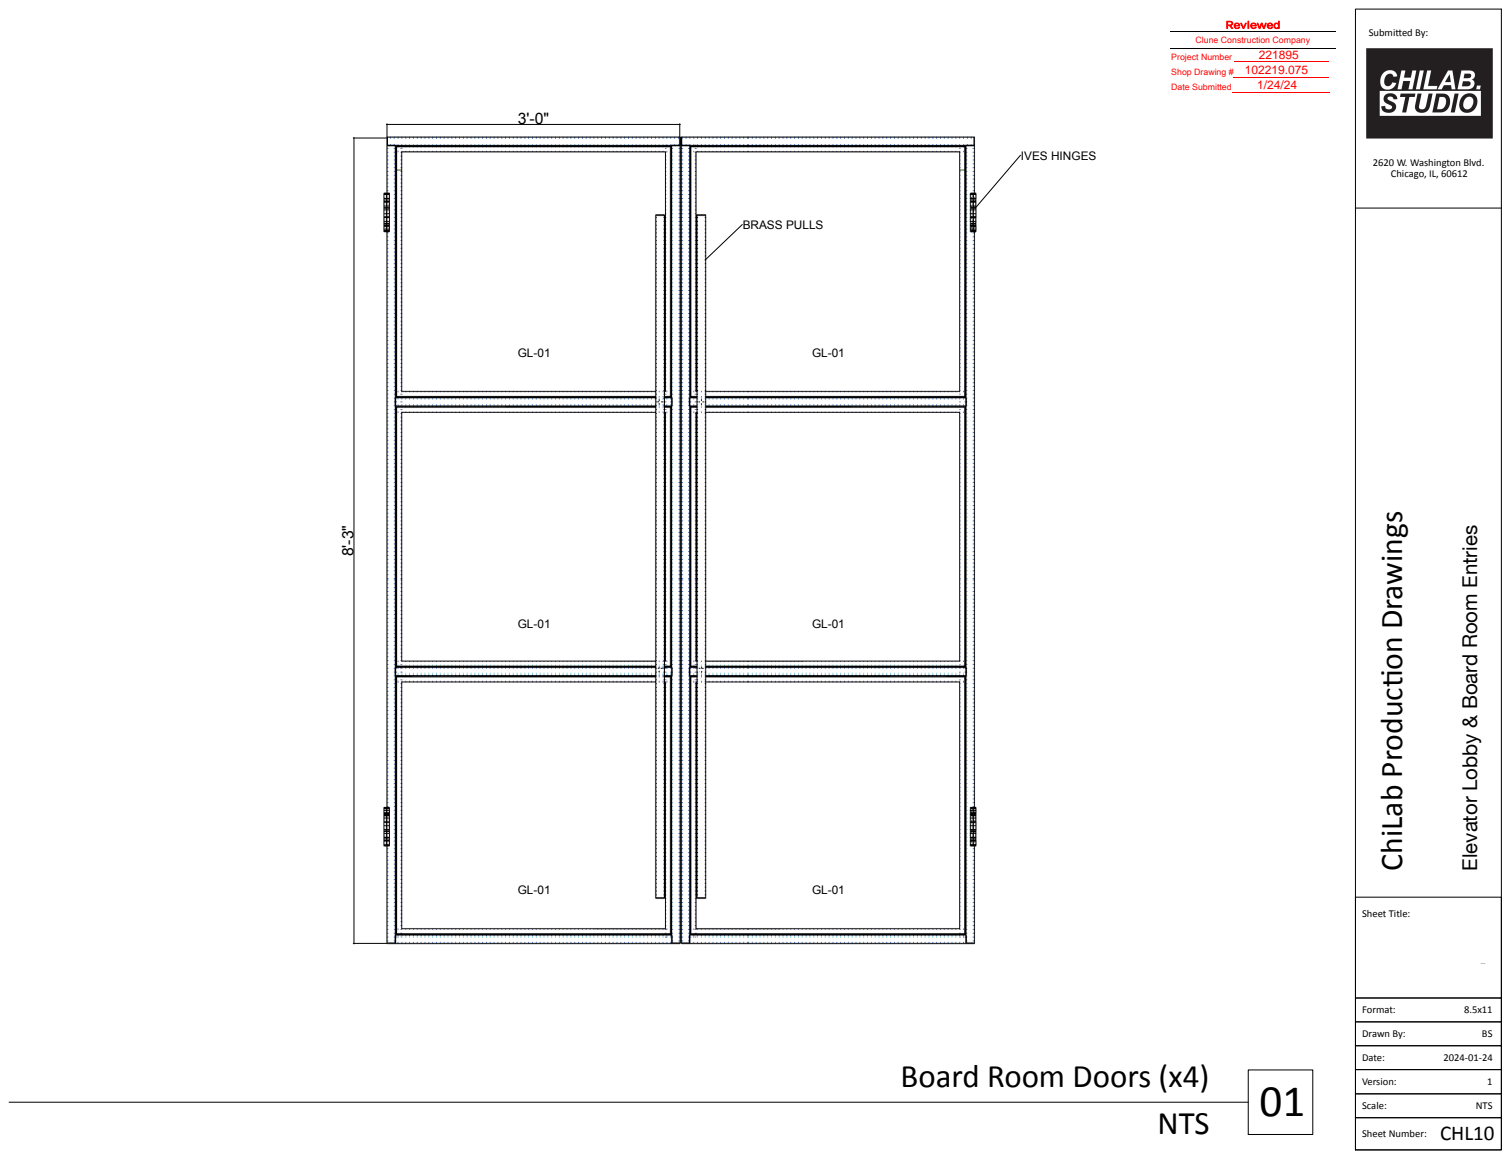
[picture p24: page 12]
Board Room Doors (x4); Drawn By:; Sheet Title:; 2620 W. Washington Blvd. Chicago, IL, 60612; IVES HINGES; BRASS PULLS; Shop Drawing #; Date Submitted

SubmiEed By: ChiLab ProducHon Drawings

Elevator Lobby & Board Room Entries

Sheet Title Line 1
Sheet Title Line 2
