Benergy80/PartitionSystem/102219.004.02 - ChiLabs 6th Floor Elevator Entrance and Board Room 021924.pdf

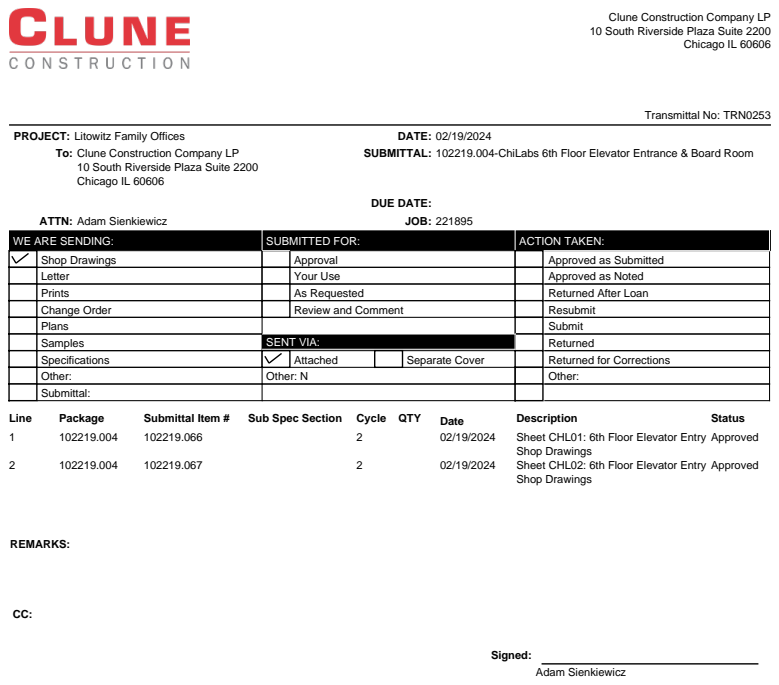
[picture p25: page 1]
Transmittal No: TRN0253; Chicago IL 60606; PROJECT: Litowitz Family Offices; DATE: 02/19/2024; DUE DATE:; ATTN: Adam Sienkiewicz; JOB: 221895; WE ARE SENDING: Shop Drawings Letter; Change Order; Prints; Specifications; Plans Samples; Submittal:; Other:; SENT VIA:; Other: N; Attached; Separate Cover; Line; Package; Submittal Item #; Sub Spec Section Cycle QTY; Date; Description; Status; Sheet CHL01: 6th Floor Elevator Entry; Shop Drawings; Approved; Sheet CHL02: 6th Floor Elevator Entry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

Clune Construction Company LP
10 South Riverside Plaza Suite 2200

Chicago IL 60606

SUBMITTAL: 102219.004-ChiLabs 6th Floor Elevator Entrance & Board Room

SUBMITTED FOR:
Approval
Your Use
As Requested
Review and Comment

ACTION TAKEN:
Approved as Submitted
Approved as Noted
Returned After Loan
Resubmit
Submit
Returned
Returned for Corrections
Other:

Transmittal No: TRN0248

Clune Construction Company LP 10 South Riverside Plaza Suite 2200 Chicago IL 60606

PROJECT: Litowitz Family Offices | DATE: 02/15/2024
Gensler Architecture, Design & Planning, P.C. 11 E Madison St Suite 300

To:
102219.004-ChiLabs 6th Floor Elevator Entrance & Board Room

SUBMITTAL:

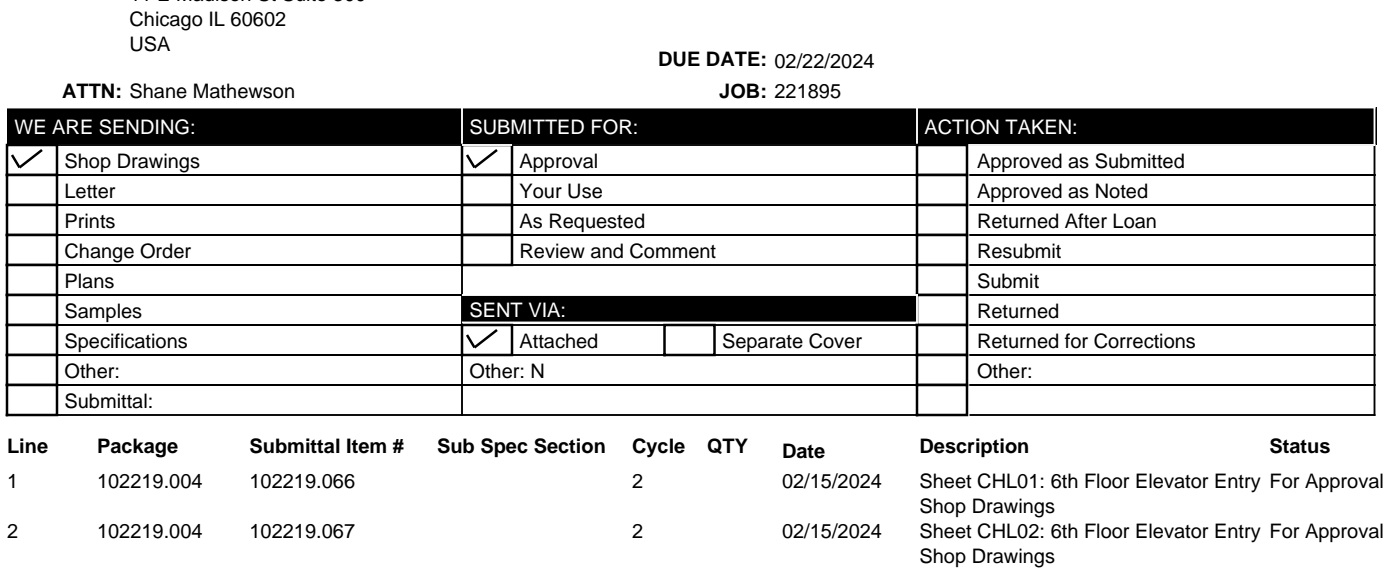
[picture p26: figure]
Chicago IL 60602 USA; DUE DATE:; ATTN: Shane Mathewson; JOB: 221895; WE ARE SENDING: Shop Drawings Letter; Change Order; Prints; Specifications; Plans Samples; Submittal:; Other:; Review and Comment; As Requested; Your Use; SUBMITTED FOR: Approval; Returned for Corrections; Returned After Loan; Submit; Approved as Noted; Approved as Submitted; Returned; ACTION TAKEN:; Resubmit; SENT VIA:; Other: N; Attached; Separate Cover; Line; Package; Submittal Item #; Sub Spec Section Cycle QTY; Date; Description; Status; Shop Drawings; For Approval

1 | 102219.004 | 102219.066 | 2 | Sheet CHL01: 6th Floor Elevator Entry
2 | 102219.004 | 102219.067 | 2 | Sheet CHL02: 6th Floor Elevator Entry

REMARKS:

CC:

Signed:
Adam Sienkiewicz

## These drawings are for the

entrance portals, as requested.

## SUBMITTAL REVIEW

NO EXCEPTIONS TAKEN.
MAKE CORRECTIONS AS NOTED. Resubmittal not required unless Contractor cannot comply with corrections noted.
REVISE AS NOTED AND RESUBMIT.
RESUBMIT PROPERLY. Submittal not reviewed for reasons noted. NOT REVIEWED. Submittal not required by Contract Documents. RECEIVED FOR CLIENT’S RECORD ONLY. Submittal not reviewed.

Gensler has reviewed this Submittal, but only for the purpose of checking for conformance with the design intent expressed in the Contract Documents. Gensler’s action on a specific item does not indicate approval of an assembly of which the item is a component, nor of an item as delivered and installed if it does not conform to the Contract Documents. Contractor is responsible for checking for deviations between this Submittal and differing information or conditions in the Contract Documents and field conditions; for determining or substantiating the accuracy and completeness of other details such as dimensions and quantities; for substantiating instructions for installation or performance of equipment or systems designed by Contractor; for construction means, methods, techniques, schedules, sequences, procedures, and fabrication processes; for errors and omissions in Submittals; for coordination of the Work of the trades, safety precautions and performing the Work in a safe and satisfactory manner and in conformance with the Contract Documents.
If more than one submittal review stamp appears on this Submittal, the most stringent action and notations thereon apply. Signature of a submittal review stamp by Gensler or a consultant does not imply that it has reviewed work not within its professional discipline or scope of
services. | v1 3/2012
By: | Date:
Project No:
Submittal:
SHANE MATHEWSON | Fri Feb 16, 2024 21.0982.000 102219.004.02 - ChiLabs 6th Floor Elevator Entrance a //?/UNC/gensler.ad/Projects/21/21.0982.000/Documentation/6/6S/102219.004.02 - ChiLab

# Submitted By: ChiLab Production Drawings

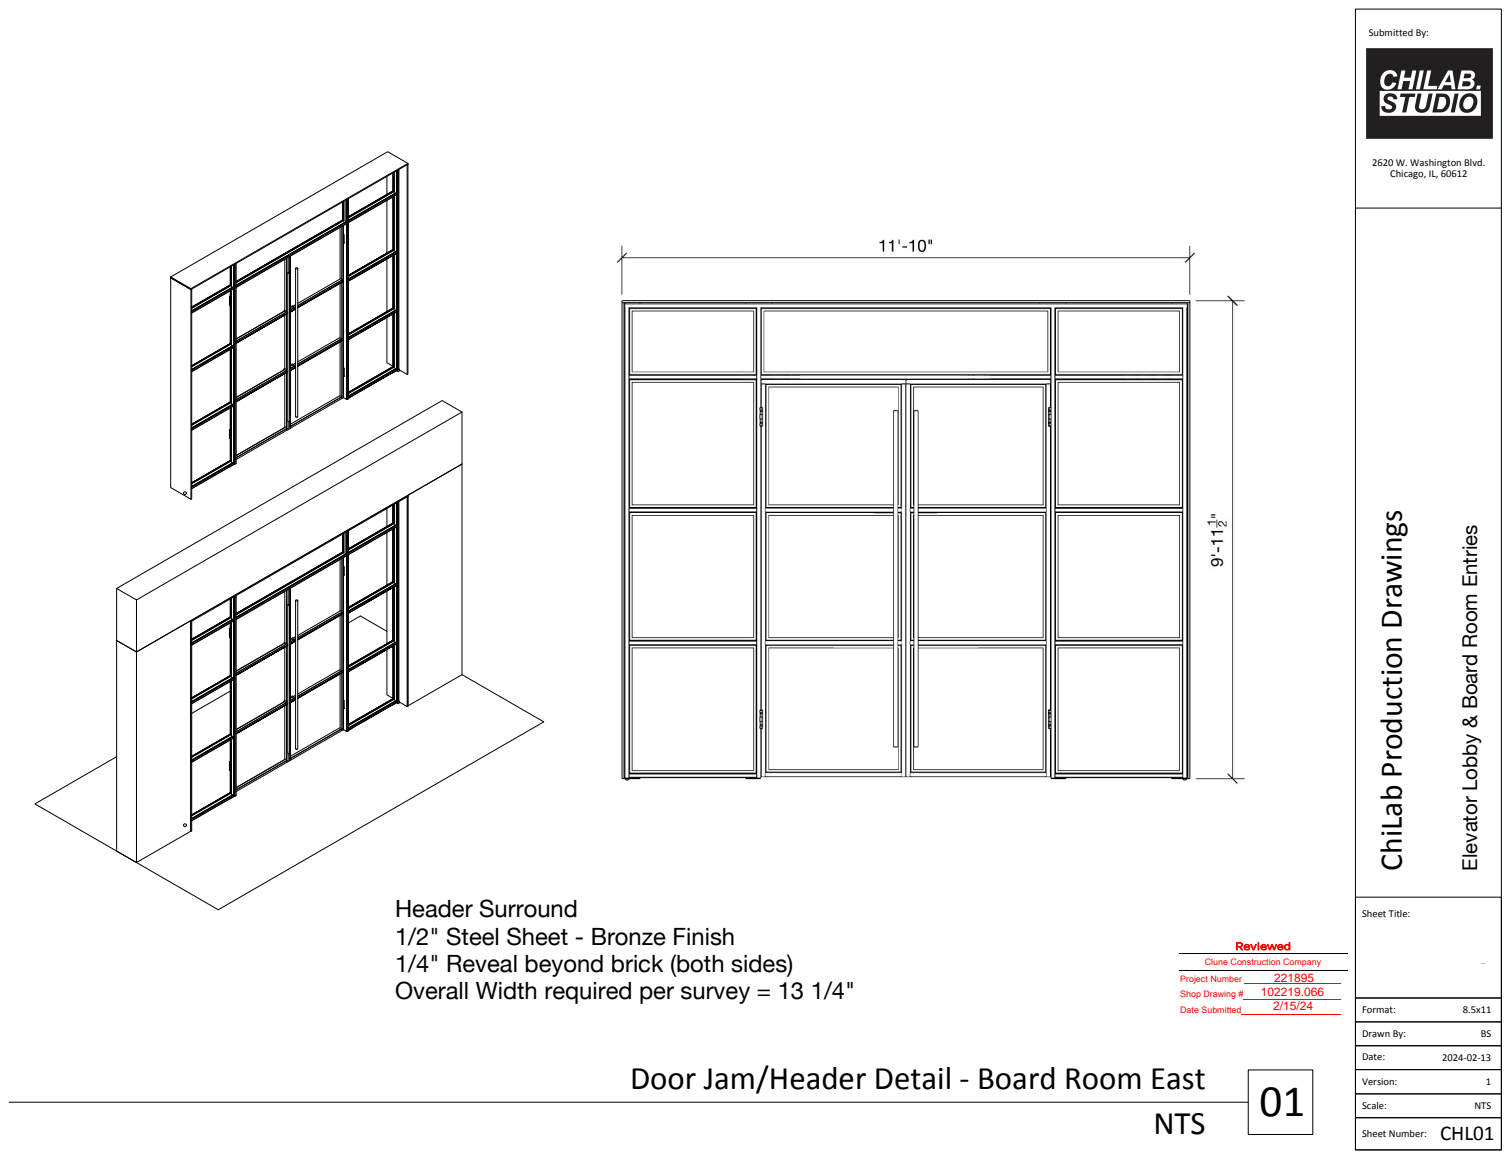
[picture p27: page 3]
NTS; 01 Door Jam/Header Detail - Board Room East; CHL01; Sheet Number:; Scale:; Version:; Date:; Drawn By:; Format:; Sheet Title:; 2620 W. Washington Blvd. Chicago, IL, 60612; Date Submitted

Elevator Lobby & Board Room Entries

Header Surround
1/2" Steel Sheet - Bronze Finish
1/4" Reveal beyond brick (both sides)
Overall Width required per survey = 13 1/4"

Reviewed
Clune Construction Company
Project Number
Shop Drawing #

Sheet Title Line 1
Sheet Title Line 2

# Submitted By: ChiLab Production Drawings

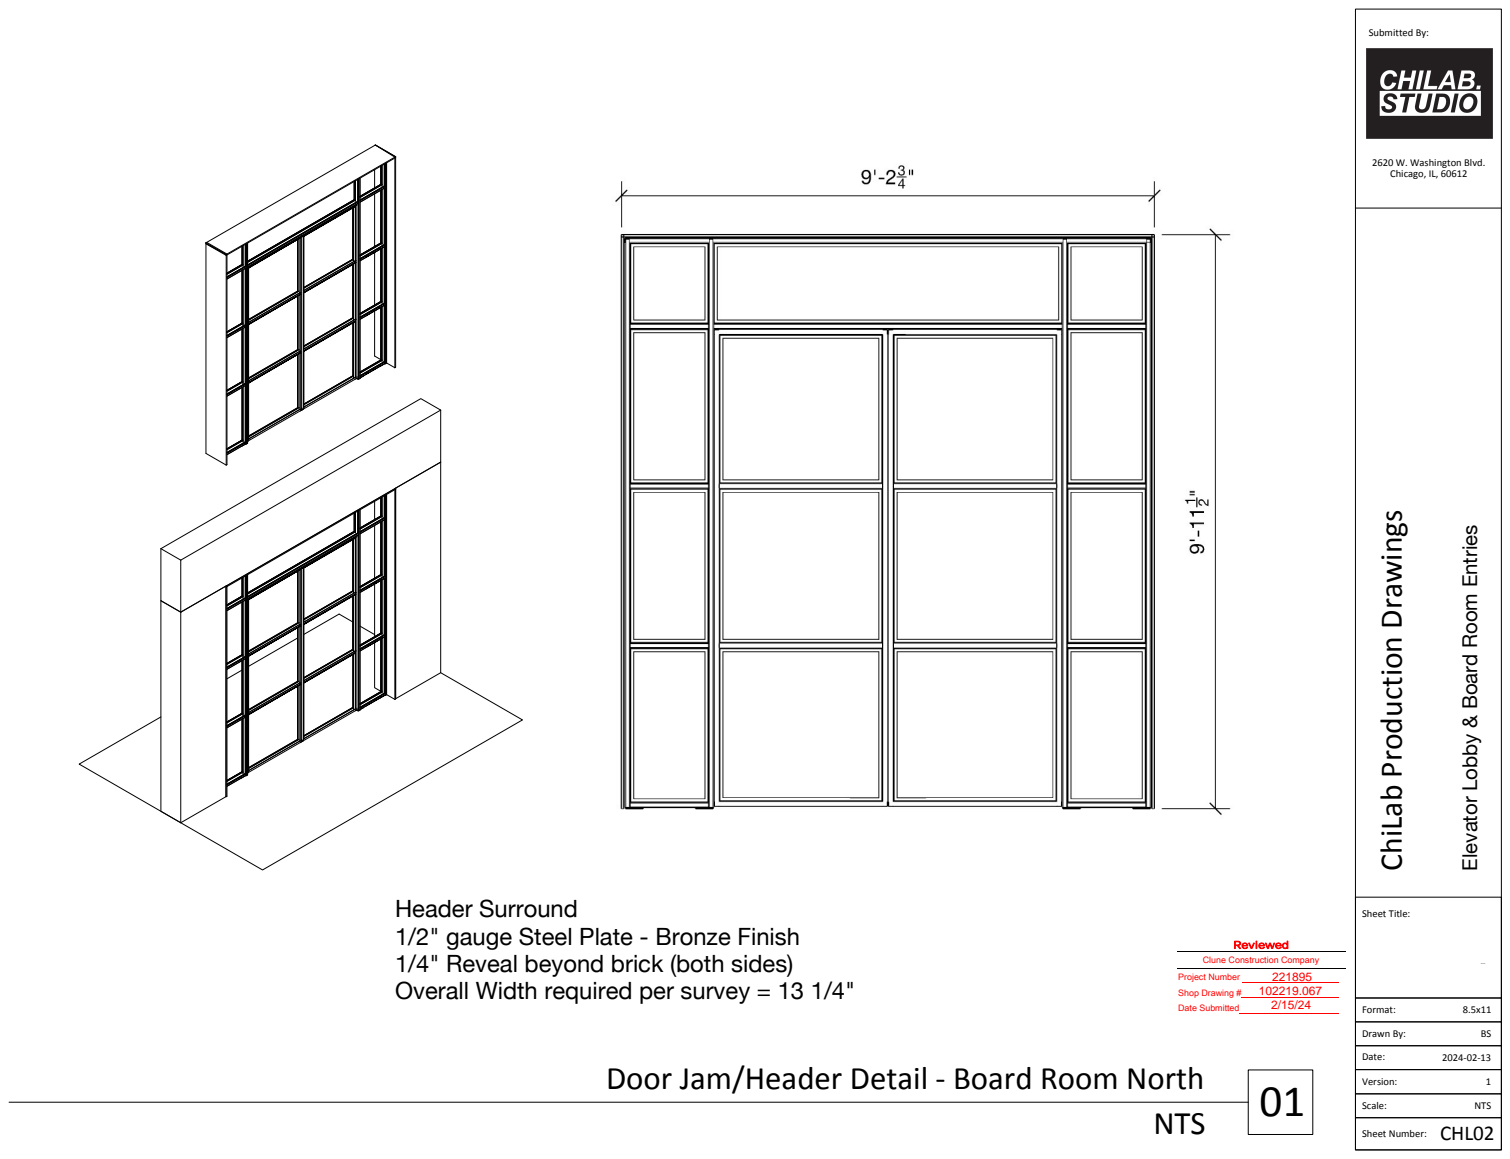
[picture p28: page 4]
NTS; CHL02; Sheet Number:; Scale:; Version:; Date:; Drawn By:; Format:; Sheet Title:; 2620 W. Washington Blvd. Chicago, IL, 60612; Date Submitted

Elevator Lobby & Board Room Entries

Header Surround
1/2" gauge Steel Plate - Bronze Finish
1/4" Reveal beyond brick (both sides)
Overall Width required per survey = 13 1/4"

Reviewed
Clune Construction Company
Project Number
Shop Drawing #

Sheet Title Line 1
Sheet Title Line 2

Door Jam/Header Detail - Board Room North
