Benergy80/PartitionSystem/(commit log)

2026-07-02 Add parametric steel + glass partition configurator
    Static Three.js app derived from the 102219.004 shop set and measured STP
    part files. Config -> placed parts, unique-part dedup, conflict checks,
    BOM with linear-ft stock totals, printable cut sheet + quote package, and
    baked GLB exports (assembly, parts library, per-part) with real hole and
    slot geometry.
    System rules encoded from the source set: cold-connection grammar (shear
    blocks, T/F clip capture, access holes), 1" base sill channel, continuous
    head-lite band with door head rail on the same line, door mid-rails
    aligned to partition rail centerlines, 2x5 header only for pivot doors
    with internal closers and no head lites. Viewer: ligh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
2026-07-02 Fix clip and shear block orientation; correct tab dims and tube gauge
    Clip bases now lie flat (anchors up), tabs stand vertical perpendicular
    to the wall, shear blocks lie flat with taps up. Tabs corrected to
    3/16 x 1-1/4 bars in pairs at 13/16 outer spread (= CHL07 passthrough
    slot); vertical/horizontal tubes set to 14-ga wall per measured corner
    radii, giving the 0.834 cavity that slip-fits the tab stack.
2026-07-02 Portal as thin plate lining; verticals bear on clip plate at grade
    The portal was rendered as a solid 5x13 block that read like the 2x5
    header - now modeled as its actual form: 1/2" plate lining (head soffit
    + jamb plates through the wall depth) showing a thin edge band in
    elevation. Verticals now sit on the 3/16" clip base plate instead of
    floating 3/4" above the slab.
2026-07-02 Close gaps at vertical heads in head-lite mode
    Verticals stopped at the underside of the top-channel band, leaving a
    1" hole through the elevation at every vertical station. In head-lite
    mode they now run full height to the top clip plate, passing through
    the channel band the same way they pass the sill and rails.
2026-07-02 Break doors into welded frame + separate glazing and hardware components
    Door leaf part is now just the welded stile/rail frame. Door lites,
    their mitered glazing angle frames (same 3/4x3/4x1/8 stock), and the
    brass pulls are individual parts with their own BOM lines, cut lengths,
    and GLB exports. Identical door and field glazing angles dedupe into
    one interchangeable line item; door glass now counts in the glass
    schedule and sqft pricing. All door-attached parts share the leaf's
    hinge pivot so the swing simulation carries them. Pull length no
    longer over-clamped (72" pulls stay 72").
2026-07-06 Door height drives the grid; decouple it from opening height
    The door leaf height is now a fixed room standard the user specifies
    (default 7'-0"; 6'-8"/7'-0"/8'-0" presets) instead of being derived from
    the opening. A horizontal rail is placed exactly at the door head: field
    rows subdivide below it, a head-lite band fills above. Changing the
    opening height now only grows/shrinks the head-lite band and never
    touches the door or the field rows below it.
    Head-lite band auto-subdivides when it exceeds 4'; when the door reaches
    within 6" of the top the top channel/header serves as the head. The
    door-head rail and its transom glass are now emitted by the main rail and
    glass loops (fixing a latent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
2026-07-06 Auto-center door among sidelites; Left/Right preference for odd splits
    Bay layout previously pinned the door to a fixed bay index, so adding
    sidelites piled them on one side (e.g. 1 left / 3 right). The door now
    auto-centers: sidelites split evenly on both sides. When the sidelite
    count is odd it can't split evenly, so a Left/Right "extra sidelite"
    toggle (shown only in that case) picks which side gets the extra bay.
    Replaces the manual "Door bay" dropdown.
2026-07-06 Shop-drawing view + parts list; head-lite congruence; drop obsolete inputs
    New: isolating a part adds a scrollable parts list (step through every
    unique component) and a "Shop drawing" toggle — an orthographic
    multi-view (elevation, plan, to-scale end section, iso, title block)
    with full dimensions and hole/slot distances called out from the outer
    edges, exportable as SVG (drawing.js).
    Head-lite congruence: the head-lite band now subdivides so no head panel
    is taller than a field panel — as the opening grows, horizontals are
    added to keep the grid module consistent.
    Removed the now-obsolete "Head lite height" and "Custom heights" inputs
    (the door drives the grid and the head lite auto-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
